nm4c/radio-remote/pihat/docs/schematic/radpi-control-hat.html

Title

# RadPi Control HAT

Raspberry Pi HAT: opto-isolated PTT, channel UP/DOWN and busy, an I2S codec with transformer-isolated radio audio, and a 13.8 V supply that powers the Pi.

RevA · draft

Date2026-11-02

Sheets7 + netlist

Board65 × 56.5 mm

GPIO17 Pi side (GND) R_PTT radio side (RGND) 5V0 power rail

Sheet 1/7

## Block diagram

Everything left of the dashed barrier is on Pi ground (GND). Everything right of it is on radio ground (RGND). Only optocouplers and transformers cross it.

Sheet 2/7

## Pi header J1

Only these pins are used. Every pin not listed is left unconnected. Pin numbers are physical header positions.

Pin | Pi function | Net | Goes to
1 | 3V3 | 3V3_PI | U2 IOVDD, Y1, U6, pull-ups
2 | 5V | 5V0 | power in (from U3)
3 | GPIO2 SDA1 | I2C_SDA | U2 SDA
4 | 5V | 5V0 | power in (from U3)
5 | GPIO3 SCL1 | I2C_SCL | U2 SCL
6 | GND | GND
9 | GND | GND
11 | GPIO17 | GPIO17 | R1 → U1 ch 1 (PTT), R8 → LED2
12 | GPIO18 PCM_CLK | I2S_BCLK | U2 BCLK
13 | GPIO27 | GPIO27 | R2 → U1 ch 2 (UP)
14 | GND | GND
15 | GPIO22 | GPIO22 | R3 → U1 ch 3 (DOWN)
16 | GPIO23 | GPIO23 | U1 pin 10 (BUSY in)
17 | 3V3 | 3V3_PI
20 | GND | GND
25 | GND | GND
27 | GPIO0 ID_SD | ID_SD | U6 SDA, R22
28 | GPIO1 ID_SC | ID_SC | U6 SCL, R23
30 | GND | GND
34 | GND | GND
35 | GPIO19 PCM_FS | I2S_LRCLK | U2 WCLK
37 | GPIO26 | CODEC_RST | U2 RESET, R21
38 | GPIO20 PCM_DIN | I2S_DOUT | ← U2 DOUT
39 | GND | GND
40 | GPIO21 PCM_DOUT | I2S_DIN | U2 DIN

Sheet 3/7

## Power

The 5V0 rail powers the Pi through header pins 2 and 4. 3V3A is a quiet analog rail for the codec; the Pi's own 3V3 is used only for logic.

Sheet 4/7

## Control

Channels 1–3 are driven from the Pi. Channel 4 is reversed: its LED sits on the radio side, so BUSY arrives isolated on GPIO23.

Sheet 5/7

## Radio connectors

All radio wiring goes through two vertical 3.5 mm pluggable headers, plugged in from above through the HAT opening. Make up one lead per radio from its accessory connector.

Sheet 6/7

## Codec

All 33 pins are shown so the KiCad symbol can be checked pin for pin. Crossed pins are no-connect.

Sheet 7/7

## Audio + ID EEPROM

Both transformers sit across the barrier. TX audio leaves the codec differentially; RX audio arrives differentially, so neither speaker wire is ever grounded.

Reference

## Netlist

Ref.pin for every connection. Use these names as KiCad net labels: same name, same net.

Net | Connects
13V8_IN | J2.1, F1.1
VIN_F | F1.2, D1 A
VIN | D1 K, D3 K, C16–C18, C19 +, U3.2 VIN, U3.3 EN
SW | U3.8, C20.2, L1.1
BOOT | U3.7, C20.1
VCC | U3.6, C28.1
FB | U3.5, R25.2, R26.1
5V0 | L1.2, C21–C23, R25.1, J1.2, J1.4, U4.3 IN, C24, R7
3V3A | U4.2 OUT, C25, U5.1 IN, U5.3 EN, C26, U2.25, U2.18, U2.24, C8, C9, C10, C13
1V8 | U5.5 OUT, C27, U2.32 DVDD, C12
3V3_PI | J1.1, J1.17, U2.7 IOVDD, C11, Y1.4, Y1.1, C14, U6.8, C15, R22, R23, R24
GND | J1 GND pins, J2.2, C16–C19, C21–C28, D3 A, R26, U3.1/9, U4.1, U5.2, U1.2/4/6/9, U2.6/17/21/26/33, Y1.2, U6.1–4, R21, LED1 K, LED2 K, JP1.2, JP2.2
GPIO17 | J1.11, R1.1, R8.1
GPIO27 | J1.13, R2.1
GPIO22 | J1.15, R3.1
GPIO23 | J1.16, U1.10 (C4)
I2C_SDA | J1.3, U2.9
I2C_SCL | J1.5, U2.8
I2S_BCLK | J1.12, U2.2
I2S_LRCLK | J1.35, U2.3
I2S_DIN | J1.40, U2.4 (codec DIN)
I2S_DOUT | J1.38, U2.5 (codec DOUT)
OSC_12M | Y1.3, R16 → U2.1 MCLK
CODEC_RST | J1.37, U2.31, R21.1
ID_SD | J1.27, U6.5, R22.2
ID_SC | J1.28, U6.6, R23.2
EE_WP | U6.7, R24.2, TP1, JP2.1
HP_P / HP_N | U2.19 / U2.20 → R14 / R15 → T1.1 / T1.3
T1 secondary | T1.6 → C1 → FB4 → R_MIC; T1.4 → RGND
RX_P / RX_N | C2 / C3 → U2.10 / U2.11
RGND | U1.11/13/15, C4, C7, T1.4, J3.2, J4.1, JP1.1
R_PTT | FB1.2, C4, J4.2
R_UP | U1.14 → JP3 ∥ R5 (not fitted), J4.3
R_DN | U1.12 → JP4 ∥ R6 (not fitted), J4.4
R_MIC | FB4.2, C7, J3.1
R_SPP / R_SPN | J3.3 / J3.4 → T2.6 / T2.4
BUSY+ | J4.5, R4.1
BUSY− | J4.6, U1.8 (K4), D4 A

Reference

## Parts

Designators match the sheets. LCSC numbers were checked against JLCPCB stock on 2 Nov 2026; put them in each symbol’s LCSC field.

Ref | Part | LCSC | JLC type
U1 | TCMT4100 quad opto, SOP-16 | C2938669 | Ext
U2 | TLV320AIC3104IRHBR codec, QFN-32 | C181753 | Ext
U3 | LMR33640ADDAR buck, HSOIC-8-EP | C2836966 | Ext
U4 | TLV76133DCYR 3.3 V LDO, SOT-223 | C7527500 | Ext
U5 | TPS7A2018PDBVR 1.8 V LDO, SOT-23-5 | C963430 | Ext
U6 | AT24C32D-SSHM-T EEPROM, SOIC-8 | C60583 | Ext
Y1 | HSO321S 12 MHz 3.3 V oscillator, 3225 | C160457 | Ext
T1, T2 | SM-LP-5001E 600:600 Ω transformer | C840532 | Ext
L1 | FXL0630-6R8-M 6.8 µH 5 A | C167221 | Ext
D1 | SS56 Schottky 60 V 5 A, SMA | C65009 | Ext
D3 | SMBJ22A TVS (Littelfuse), SMB | C224015 | Ext
D4 | 1N4148WS, SOD-323 | C2128 | Basic
F1 | 1812L150/33GR PTC 1.5 A 33 V | C18198333 | Ext
LED1, LED2 | KT-0603R red LED, 0603 | C2286 | Basic
FB1, FB4 | GZ1608D601TF ferrite 600 Ω, 0603 | C1002 | Basic
R1–R3 | 470 Ω 0603 | C23179 | Basic
R4 | 2.2 kΩ 0603 | C4190 | Basic
R5, R6 | Not fitted: 0603 footprints for ladder values (JP3/JP4 bridge them) | — | DNP
R7, R8, R24 | 1 kΩ 0603 | C21190 | Basic
R11, R12, R13, R21 | 10 kΩ 0603 | C25804 | Basic
R14–R16 | 33 Ω 0603 | C23140 | Basic
R22, R23 | 3.9 kΩ 0603 | C23018 | Basic
R25 | 82 kΩ 0603 1 % | C23254 | Basic
R26 | 20 kΩ 0603 1 % | C4184 | Basic
C1 | 1 µF 50 V X7R 0805 | C28323 | Basic
C2, C3, C24, C26–C28 | 1 µF 50 V X5R 0603 | C15849 | Basic
C4, C7 | 100 pF C0G 0603 | C14858 | Basic
C8–C12, C14, C15, C20 | 100 nF 50 V X7R 0603 | C14663 | Basic
C13, C25 | 10 µF 25 V X5R 0805 | C15850 | Basic
C16–C18 | 2.2 µF 50 V X7R 1206 | C50254 | Basic
C19 | 100 µF 50 V electrolytic 8×10.2 | C72480 | Ext
C21–C23 | 22 µF 25 V X5R 1206 | C12891 | Basic
J1 | 2×20 female header 2.54 mm | C2977589 | DNP · hand-solder
J2 | XY2500V-F-3.5-2P pluggable header, 3.5 mm, vertical, closed | C880554 | DNP · hand-solder
J3 | XY2500V-F-3.5-4P pluggable header, 3.5 mm, vertical, closed | C880556 | DNP · hand-solder
J4 | XY2500V-F-3.5-6P pluggable header, 3.5 mm, vertical, closed | C880558 | DNP · hand-solder
JP1–JP4, TP1 | PCB features only (solder jumpers; JP3/JP4 are closed by default; test pad) | — | —

Reference

## Before layout

1. Y1 pinout. The HSO321S datasheet is encrypted, so pin numbers follow the usual 3225 layout. Confirm before layout; tying pin 1 high is safe either way.
2. U3 stock. LMR33640ADDAR (C2836966) is an Extended part. LCSC showed about 2,400 in stock, but one JLCPCB snapshot showed only 6 available to order. Check the live JLC page before ordering; pre-order or consign if it is short.
3. Codec clocking. Y1 drives MCLK at 12 MHz. simple-audio-card always clocks the codec from MCLK, so a small custom overlay (codec at 0x18, reset on GPIO26, 12 MHz system clock) runs it correctly. The stock dacberry400 overlay clocks the PLL from BCLK while claiming 12 MHz: don't use it on this board.
4. IOVDD. Runs at 3.3 V (3V3_PI) to match Pi logic. The dacberry400 overlay describes IOVDD as 1.8 V; that only names a regulator for the driver and doesn't change the hardware.
5. Connector footprints. J2–J4 use footprints made from LCSC's data for the exact XY2500V-F parts (1.4 mm drills, 2.2 mm pads). Plugs go in from above, so leave room above them in the case opening.
6. Back-feeding. Don't power the Pi from USB-C with the HAT fitted and 13.8 V off: the Pi's 5 V would sit on the LMR33640's output with no input, which its datasheet says not to allow.
7. Isolation clearance. Keep RGND copper and every radio-side net at least 2 mm from GND-side copper, including under U1 and T1/T2.

Net-label style: a label with the same name on any sheet is the same net, as in KiCad. Pin numbers come from each part's datasheet; check them against the KiCad symbol you use.
