nm4c/radio-remote/assets/control-head/output/control-head-base@2x.png

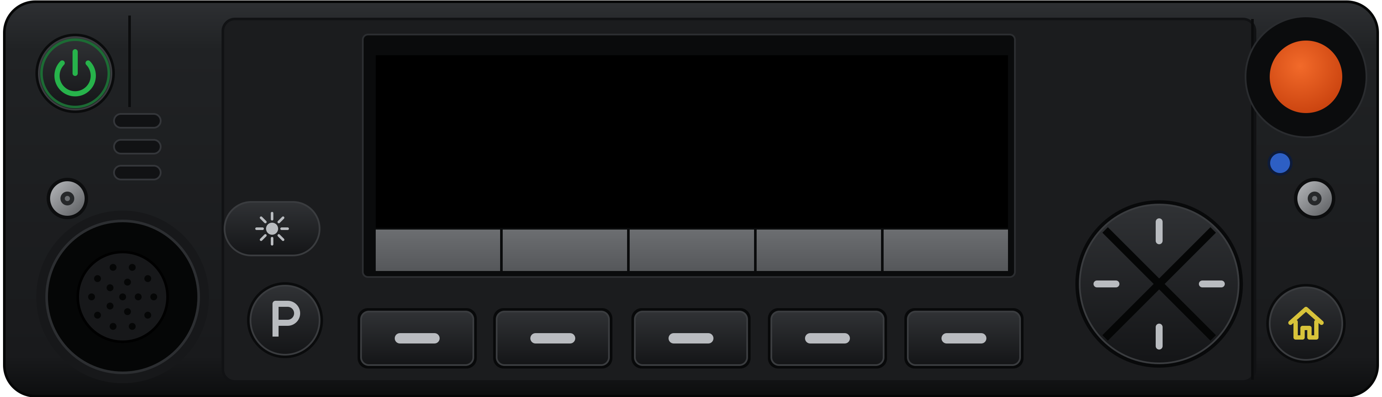
assets/control-head/output/control-head-base@2x.png
