nm4c/radio-remote/assets/control-head/output/control-head-cutout@2x.png

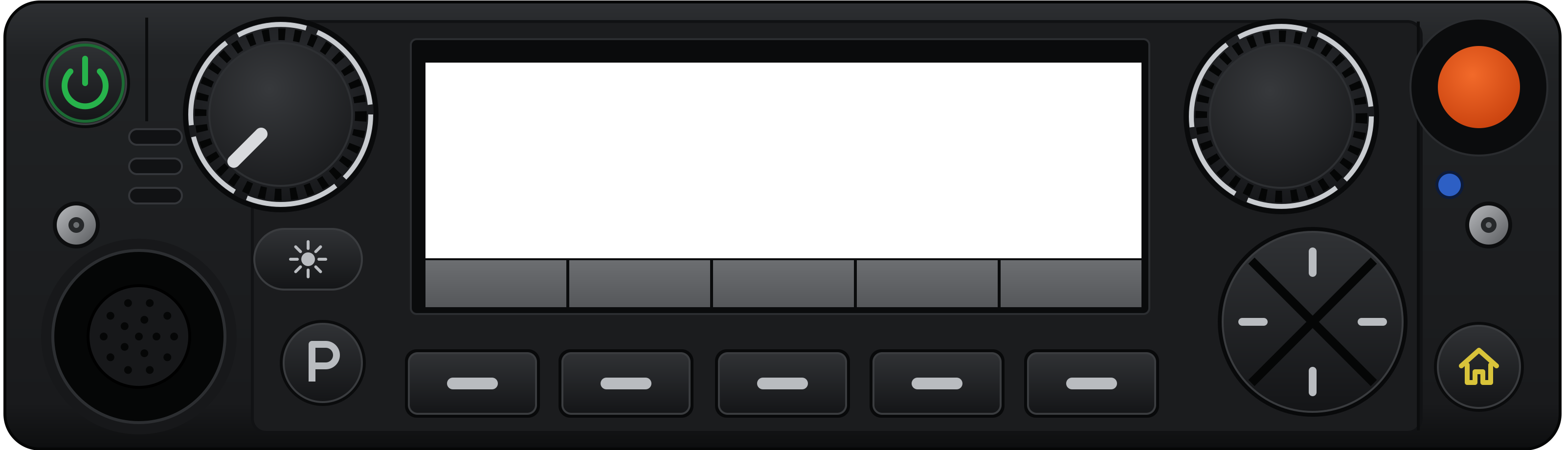
assets/control-head/output/control-head-cutout@2x.png
