nm4c/radio-remote/assets/control-head/output/handheld-sample@2x.png

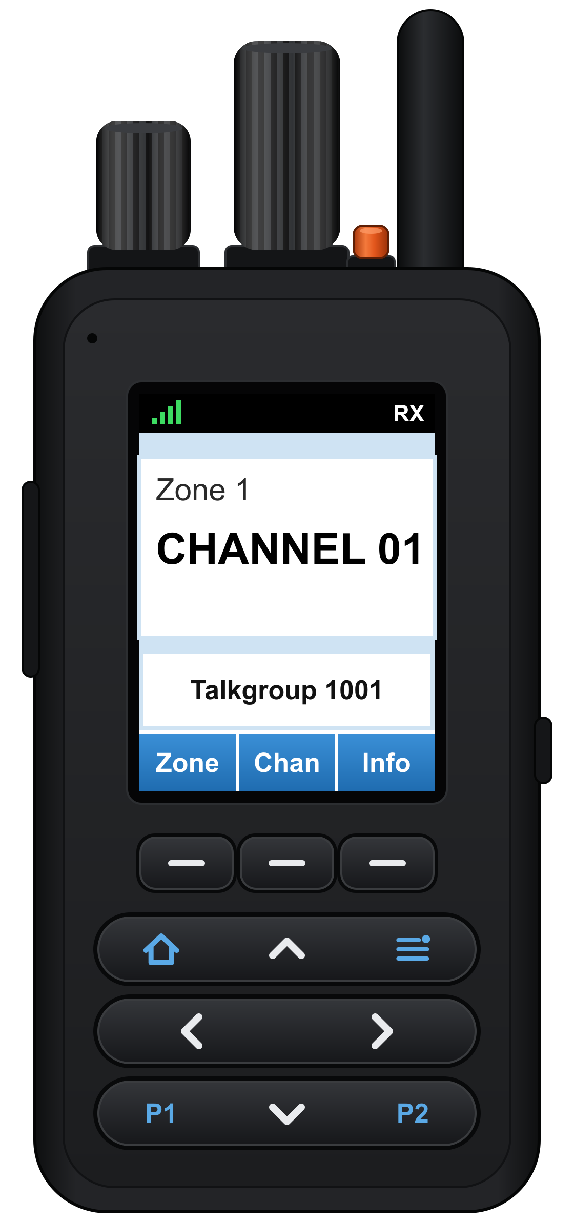
assets/control-head/output/handheld-sample@2x.png
