nm4c/radio-remote/assets/control-head/output/handheld@2x.png

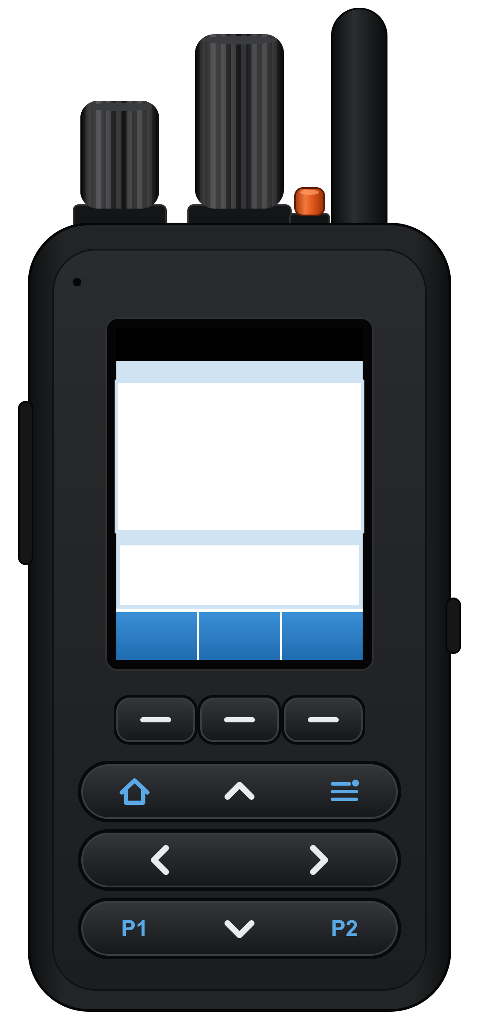
assets/control-head/output/handheld@2x.png
