nm4c/radio-remote/assets/control-head/output/knob-channel@2x.png

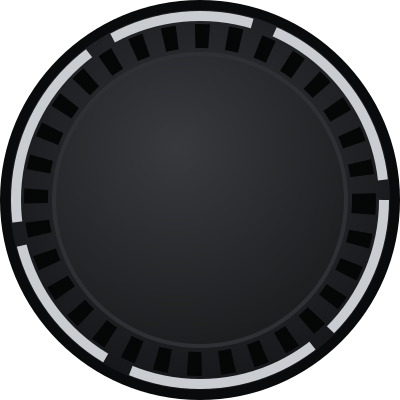
assets/control-head/output/knob-channel@2x.png
