nm4c/radio-remote/pihat/docs/BOM.md

# RadPi Control HAT: BoM notes (Rev A)

The full parts list, with designators, is in the schematic page
([`schematic/radpi-control-hat.html`](schematic/radpi-control-hat.html), "Parts" section) and in
[`jlc-bom.csv`](jlc-bom.csv), ready to upload to JLCPCB. Both come from the same list in
`schematic/gen.py`. Change the list there, then run `python3 gen.py` to update both.

LCSC numbers, JLC part type and stock were checked against JLCPCB on **2 Nov 2026**. Stock moves,
so re-check before ordering.

## Cost summary

| | Unique parts |
|---|---|
| **Basic** (no loading fee) | 18 |
| **Extended** (≈ US$3 each, per order) | 13 |

J1 (Pi header) and J2–J4 (pluggable headers) are **Do Not Populate**: through-hole, soldered by
hand. That leaves JLC only SMD parts, so the board qualifies for the cheaper "Economic" assembly,
and about US$39 in loading fees per order, not per board. To cut it further:
1. **Leave the power section off** (U3, L1, D1, D3, F1, C19, C28) if the Pi has its own supply. That's
   6 fewer Extended parts. The codec rails (U4, U5) are still needed and run from the Pi's 5 V.

## Design choices

- **Basic parts wherever possible:** all resistors, nearly all capacitors, ferrites, LEDs and D4.
- **Reused values:** 33 Ω for all series resistors, 10 kΩ for the pads and pull-downs, 100 pF and a
  ferrite on the two RF-sensitive radio lines (PTT and MIC).
- **Synchronous buck:** the LMR33640 has its own low-side switch and internal compensation, so
  there is no catch diode, compensation network or frequency resistor.
- **TI regulators:** TLV76133 for 3.3 V. The TLV76118 (1.8 V) has too little stock, so the 1.8 V
  rail uses a TPS7A2018 instead: TI, very low noise, 11k in stock.
  Avoid the "TP"-prefixed look-alikes JLC lists (3PEAK clones, not TI).
- **TCMT4100 quad opto:** one package for all four channels. At its 50 % minimum gain, 470 Ω from
  3.3 V (≈ 4 mA) still sinks ≥ 2 mA on the radio side.
- **No trimmers or TX pad:** the codec sets the TX level in software, from line level down to mic
  level. The RX pad (R11/R12/R13, −9.5 dB) suits line-level RX audio; from a speaker output, fit
  R13 = 1 kΩ (−26 dB).
- **Feedback from Basic values only:** 82 kΩ over 20 kΩ with the LMR33640's 1.0 V reference gives 5.10 V.
- **Pluggable radio connectors:** Xinlaiya XY2500V-F, 3.5 mm pitch, vertical with closed ends,
  8 A / 300 V, so the plugs go in from above through the HAT opening. J2 13.8 V in (2 way), J3
  audio (4 way: TX, TX return, RX+, RX−), J4 radio (6 way: ground, PTT, UP, DOWN, BUSY+, BUSY−).
  Each radio gets its own lead with mating 3.5 mm plugs (XY2500F / Phoenix MC 1,5/x-ST-3,5 style).

## Still to do before ordering

See the "Before layout" checklist at the end of the schematic page. In short:
- **Y1 pinout:** confirm it (the datasheet is encrypted).
- **U3 stock:** LMR33640ADDAR (C2836966) is Extended. One JLCPCB snapshot showed very few
  available to order, so check the live page; pre-order or consign if it is short.
- **Codec clock:** confirm the clock setup at bring-up.
- **Connector footprints:** J2–J4 use footprints made from LCSC's data for the exact XY2500V-F
  parts (1.4 mm drills). Leave room above them for the plugs and wires.
- **Isolation clearance:** keep radio-side copper ≥ 2 mm from Pi-side copper.
