nm4c/radio-remote/pihat/docs/jlc-bom.csv

Comment | Designator | Footprint | LCSC Part #
TCMT4100 quad opto | U1 | SOIC-16_4.4x10.3mm_P1.27mm | C2938669
TLV320AIC3104IRHBR codec | U2 | QFN-32-1EP_5x5mm_P0.5mm | C181753
LMR33640ADDAR buck | U3 | HSOP-8-1EP_3.9x4.9mm_P1.27mm | C2836966
TLV76133DCYR 3.3 V LDO | U4 | SOT-223-3_TabPin2 | C7527500
TPS7A2018PDBVR 1.8 V LDO | U5 | SOT-23-5 | C963430
AT24C32D-SSHM-T EEPROM | U6 | SOIC-8_3.9x4.9mm_P1.27mm | C60583
HSO321S 12 MHz 3.3 V oscillator | Y1 | Oscillator_SMD_3225-4Pin | C160457
SM-LP-5001E 600:600 Ω transformer | T1,T2 | Bourns_SM-LP-5001 | C840532
FXL0630-6R8-M 6.8 µH 5 A | L1 | L_Changjiang_FXL0630 | C167221
SS56 Schottky 60 V 5 A | D1 | D_SMA | C65009
SMBJ22A TVS (Littelfuse) | D3 | D_SMB | C224015
1N4148WS | D4 | D_SOD-323 | C2128
1812L150/33GR PTC 1.5 A 33 V | F1 | Fuse_1812 | C18198333
KT-0603R red LED | LED1,LED2 | LED_0603 | C2286
GZ1608D601TF ferrite 600 Ω | FB1,FB4 | L_0603 | C1002
470 Ω 0603 | R1,R2,R3 | R_0603 | C23179
2.2 kΩ 0603 | R4 | R_0603 | C4190
1 kΩ 0603 | R7,R8,R24 | R_0603 | C21190
10 kΩ 0603 | R11,R12,R13,R21 | R_0603 | C25804
33 Ω 0603 | R14,R15,R16 | R_0603 | C23140
3.9 kΩ 0603 | R22,R23 | R_0603 | C23018
82 kΩ 0603 1 % | R25 | R_0603 | C23254
20 kΩ 0603 1 % | R26 | R_0603 | C4184
1 µF 50 V X7R 0805 | C1 | C_0805 | C28323
1 µF 50 V X5R 0603 | C2,C3,C24,C26,C27,C28 | C_0603 | C15849
100 pF C0G 0603 | C4,C7 | C_0603 | C14858
100 nF 50 V X7R 0603 | C8,C9,C10,C11,C12,C14,C15,C20 | C_0603 | C14663
10 µF 25 V X5R 0805 | C13,C25 | C_0805 | C15850
2.2 µF 50 V X7R 1206 | C16,C17,C18 | C_1206 | C50254
100 µF 50 V electrolytic 8×10.2 | C19 | CP_Elec_8x10.2 | C72480
22 µF 25 V X5R 1206 | C21,C22,C23 | C_1206 | C12891
