nm4c/radio-remote/kicad-shared/3dmodels/Kinghelm_KH-SMAK-SMT.step

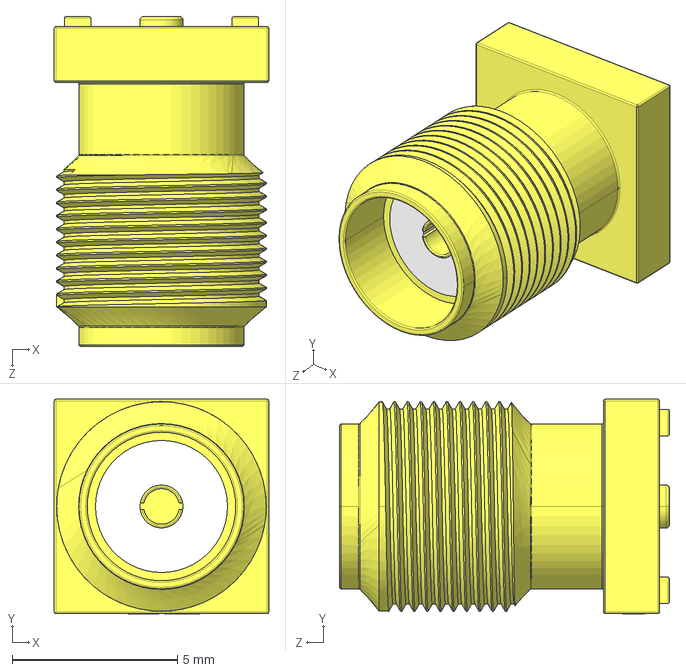
[picture p13: CAD file, 2026-11-11]
kicad-shared/3dmodels/Kinghelm_KH-SMAK-SMT.step
6.50 x 6.50 x 10.0 mm
