nm4c/radio-remote/kicad-shared/3dmodels/TI_WSON-10_DSC.step

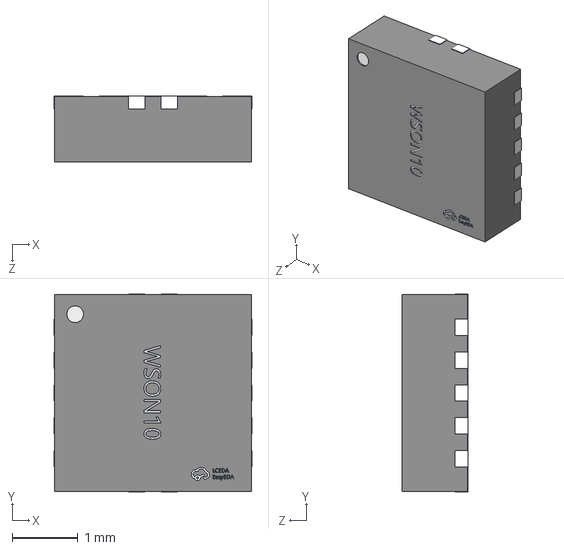
[picture p14: CAD file, 2026-11-11]
kicad-shared/3dmodels/TI_WSON-10_DSC.step
3.02 x 3.02 x 1.01 mm
