nm4c/radio-remote/kicad-shared/3dmodels/Xinlaiya_XY2500V-F-3.5-4P.step

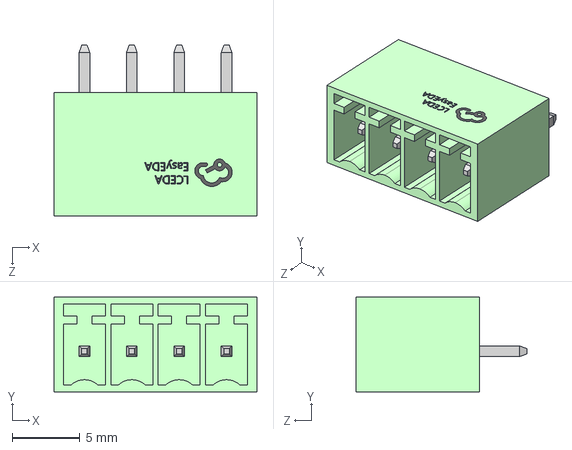
[picture p15: CAD file, 2026-11-09]
kicad-shared/3dmodels/Xinlaiya_XY2500V-F-3.5-4P.step
15.0 x 7.00 x 12.6 mm
