nm4c/radio-remote/kicad-shared/3dmodels/Xinlaiya_XY2500V-F-3.5-2P.step

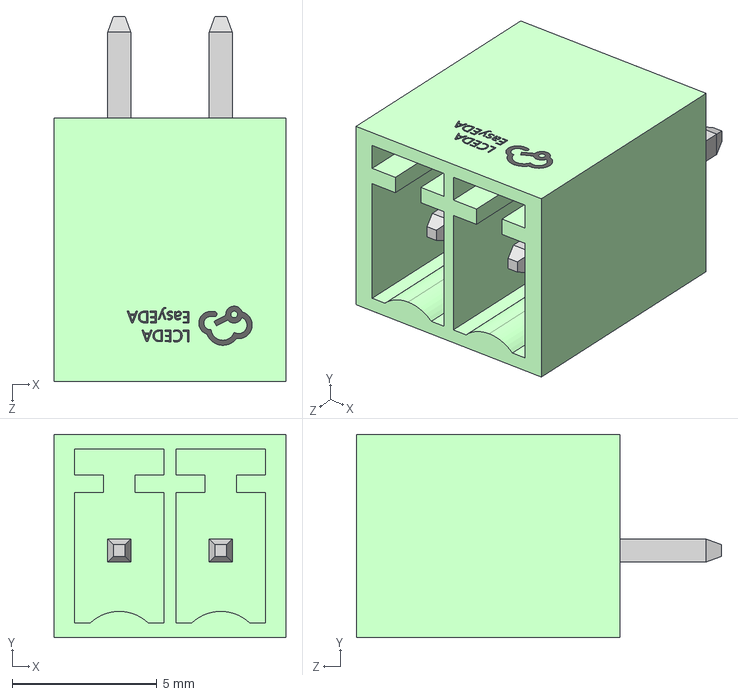
[picture p17: CAD file, 2026-11-09]
kicad-shared/3dmodels/Xinlaiya_XY2500V-F-3.5-2P.step
8.00 x 7.00 x 12.6 mm
