nm4c/radio-remote/kicad-shared/3dmodels/PTC_1812_4.5x3.2x1.0mm.step

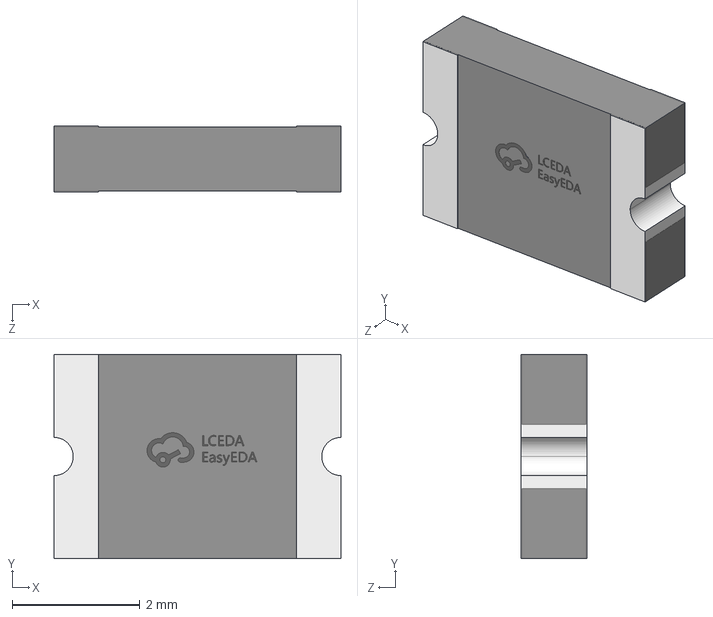
[picture p18: CAD file, 2026-11-09]
kicad-shared/3dmodels/PTC_1812_4.5x3.2x1.0mm.step
4.50 x 3.20 x 1.04 mm
