nm4c/radio-remote/kicad-shared/3dmodels/Oscillator_3225_HSO321S.step

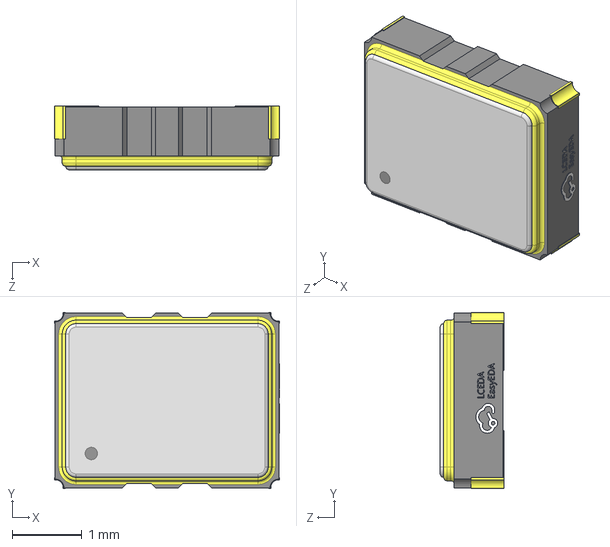
[picture p19: CAD file, 2026-11-09]
kicad-shared/3dmodels/Oscillator_3225_HSO321S.step
3.22 x 2.52 x 0.91 mm
