nm4c/radio-remote/kicad-shared/3dmodels/Bourns_SM-LP-5001E.step

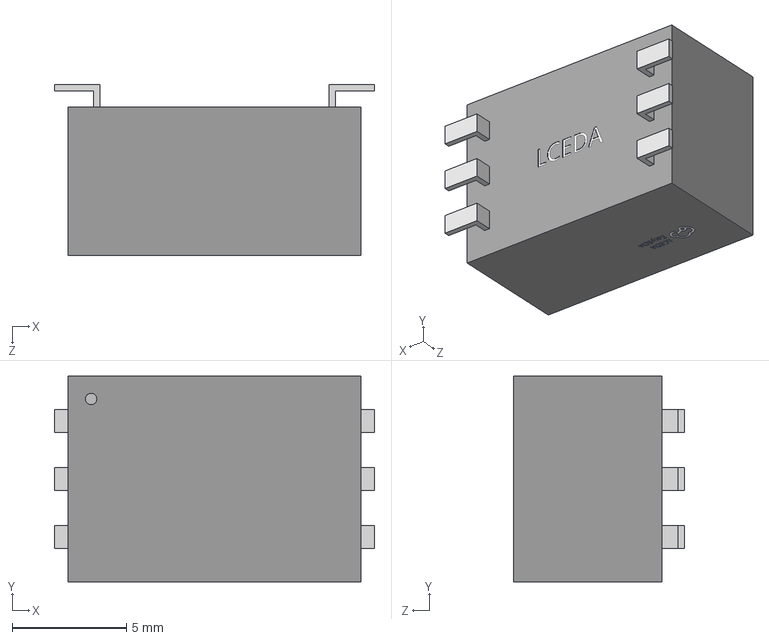
[picture p20: CAD file, 2026-11-09]
kicad-shared/3dmodels/Bourns_SM-LP-5001E.step
14.0 x 9.00 x 7.50 mm
