nm4c/radio-remote/kicad-shared/3dmodels/NiceRF_SA818S.step

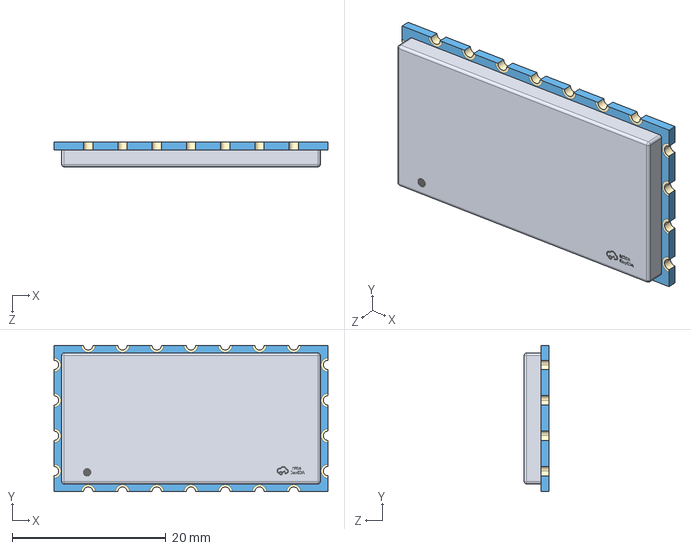
[picture p21: CAD file, 2026-11-09]
kicad-shared/3dmodels/NiceRF_SA818S.step
35.6 x 19.0 x 3.22 mm
