nm4c/radio-remote/sa818s-hat/sa818s-hat.kicad_pcb

## KiCad design sa818s-hat/sa818s-hat.kicad_pcb (2026-11-12)

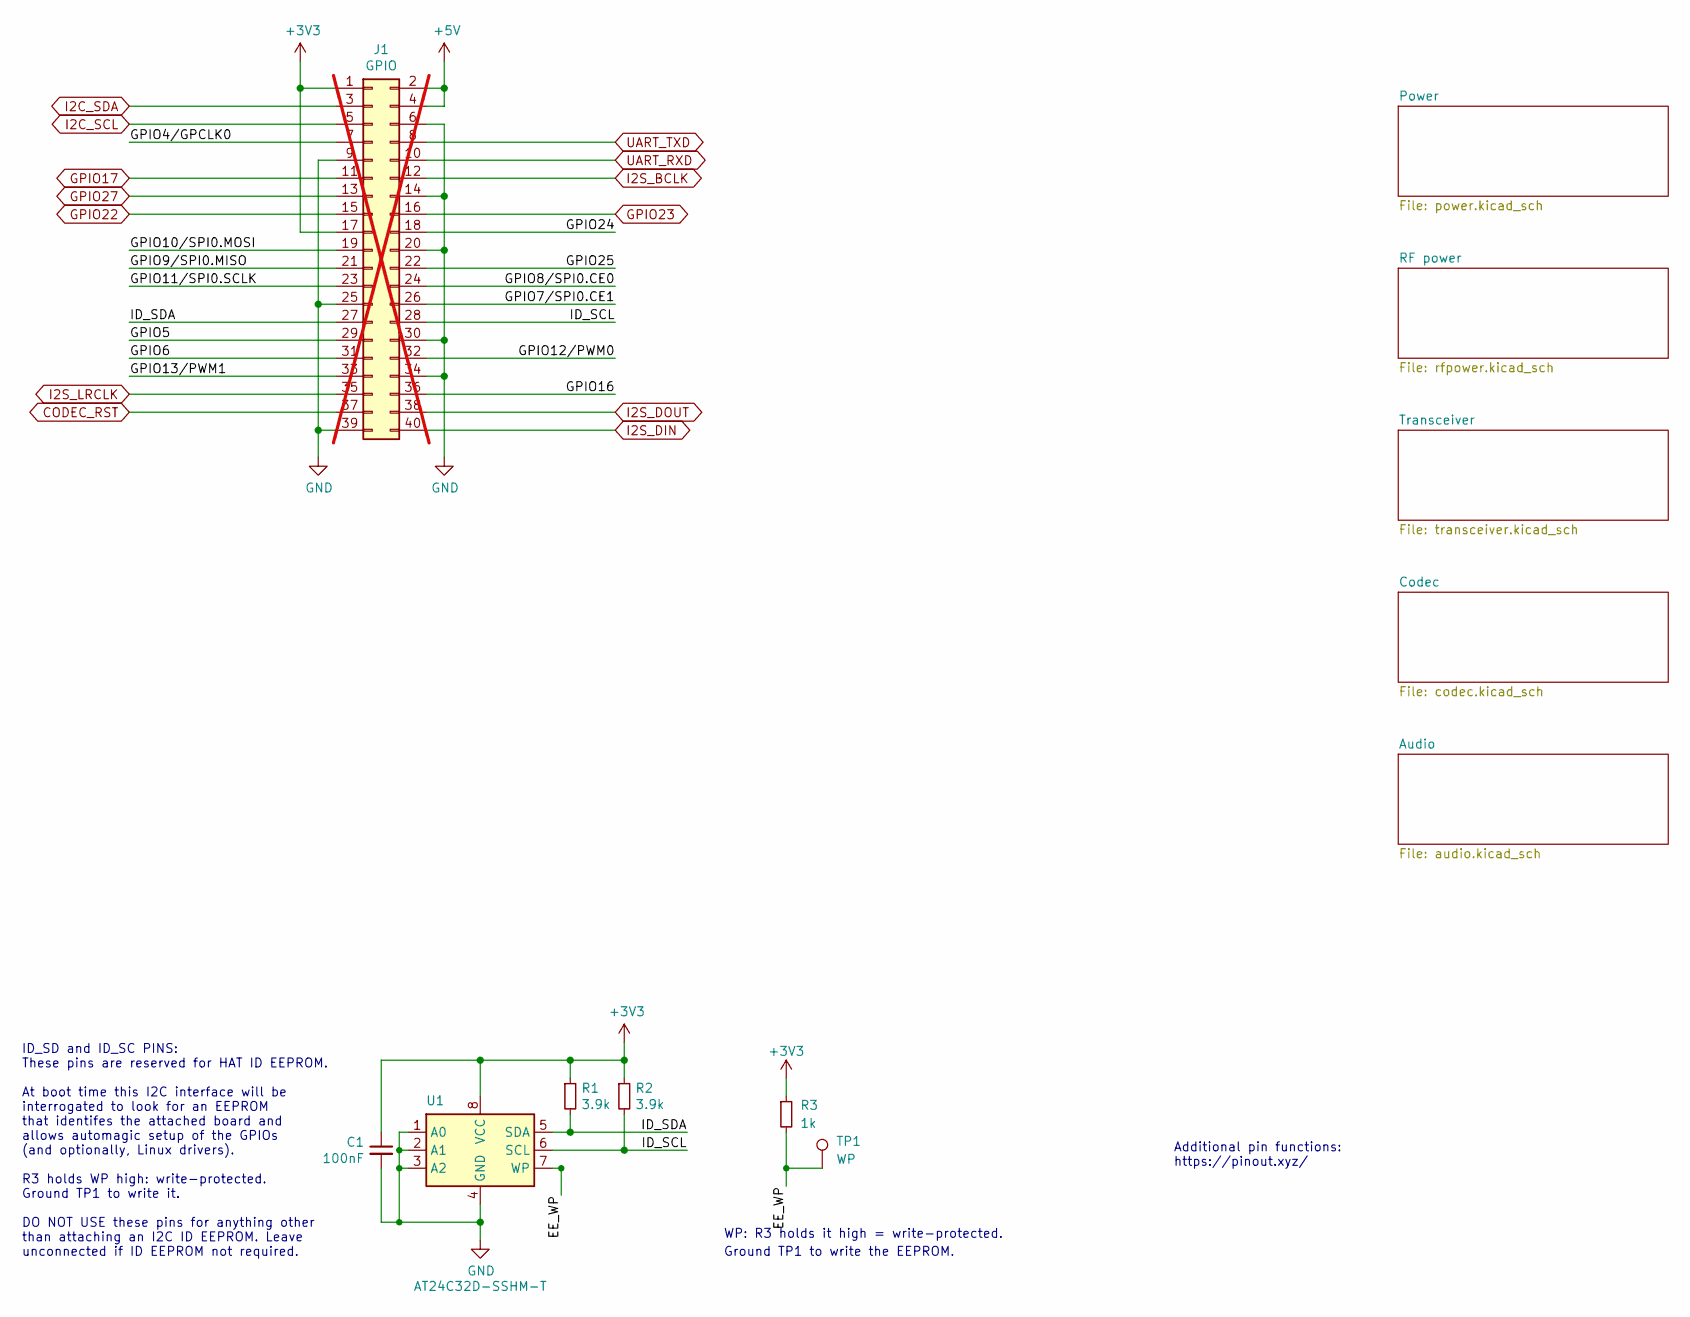
[picture p22: schematic sa818s-hat.kicad_sch]

Parts:
C1: 100nF; C_0603_1608Metric; LCSC C14663
J1: GPIO; PinSocket_2x20_P2.54mm_Vertical; LCSC C2977589; not fitted
R1, R2: 3.9k; R_0603_1608Metric; LCSC C23018
R3: 1k; R_0603_1608Metric; LCSC C21190
TP1: WP; TestPoint_Pad_D1.5mm
U1: AT24C32D-SSHM-T; SOIC-8_3.9x4.9mm_P1.27mm; LCSC C60583

Connections:
+3V3: C1.1, J1.1, J1.17, R1.1, R2.1, R3.1, U1.8 (VCC); also elsewhere on the board
+5V: J1.2, J1.4; also elsewhere on the board
/EE_WP: R3.2, TP1.1 (1_1), U1.7 (WP)
/GPIO4/GPCLK0: J1.7
/GPIO5: J1.29
/GPIO6: J1.31
/GPIO7/SPI0.CE1: J1.26
/GPIO8/SPI0.CE0: J1.24
/GPIO9/SPI0.MISO: J1.21
/GPIO10/SPI0.MOSI: J1.19
/GPIO11/SPI0.SCLK: J1.23
/GPIO12/PWM0: J1.32
/GPIO13/PWM1: J1.33
/GPIO16: J1.36
/GPIO24: J1.18
/GPIO25: J1.22
/ID_SCL: J1.28, R2.2, U1.6 (SCL)
/ID_SDA: J1.27, R1.2, U1.5 (SDA)
CODEC_RST: J1.37; also elsewhere on the board
GND: C1.2, J1.6, J1.9, J1.14, J1.20, J1.25, J1.30, J1.34, J1.39, U1.1 (A0), U1.2 (A1), U1.3 (A2), U1.4 (GND); also elsewhere on the board
GPIO17: J1.11; also elsewhere on the board
GPIO22: J1.15; also elsewhere on the board
GPIO23: J1.16; also elsewhere on the board
GPIO27: J1.13; also elsewhere on the board
I2C_SCL: J1.5; also elsewhere on the board
I2C_SDA: J1.3; also elsewhere on the board
I2S_BCLK: J1.12; also elsewhere on the board
I2S_DIN: J1.40; also elsewhere on the board
I2S_DOUT: J1.38; also elsewhere on the board
I2S_LRCLK: J1.35; also elsewhere on the board
UART_RXD: J1.10; also elsewhere on the board
UART_TXD: J1.8; also elsewhere on the board

Notes on the sheet:
Additional pin functions: https://pinout.xyz/
ID_SD and ID_SC PINS: These pins are reserved for HAT ID EEPROM. At boot time this I2C interface will be interrogated to look for an EEPROM that identifes the attached board and allows automagic setup of the GPIOs (and optionally, Linux drivers). R3 holds WP high: write-protected. Ground TP1 to wri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
WP: R3 holds it high = write-protected.
Ground TP1 to write the EEPROM.

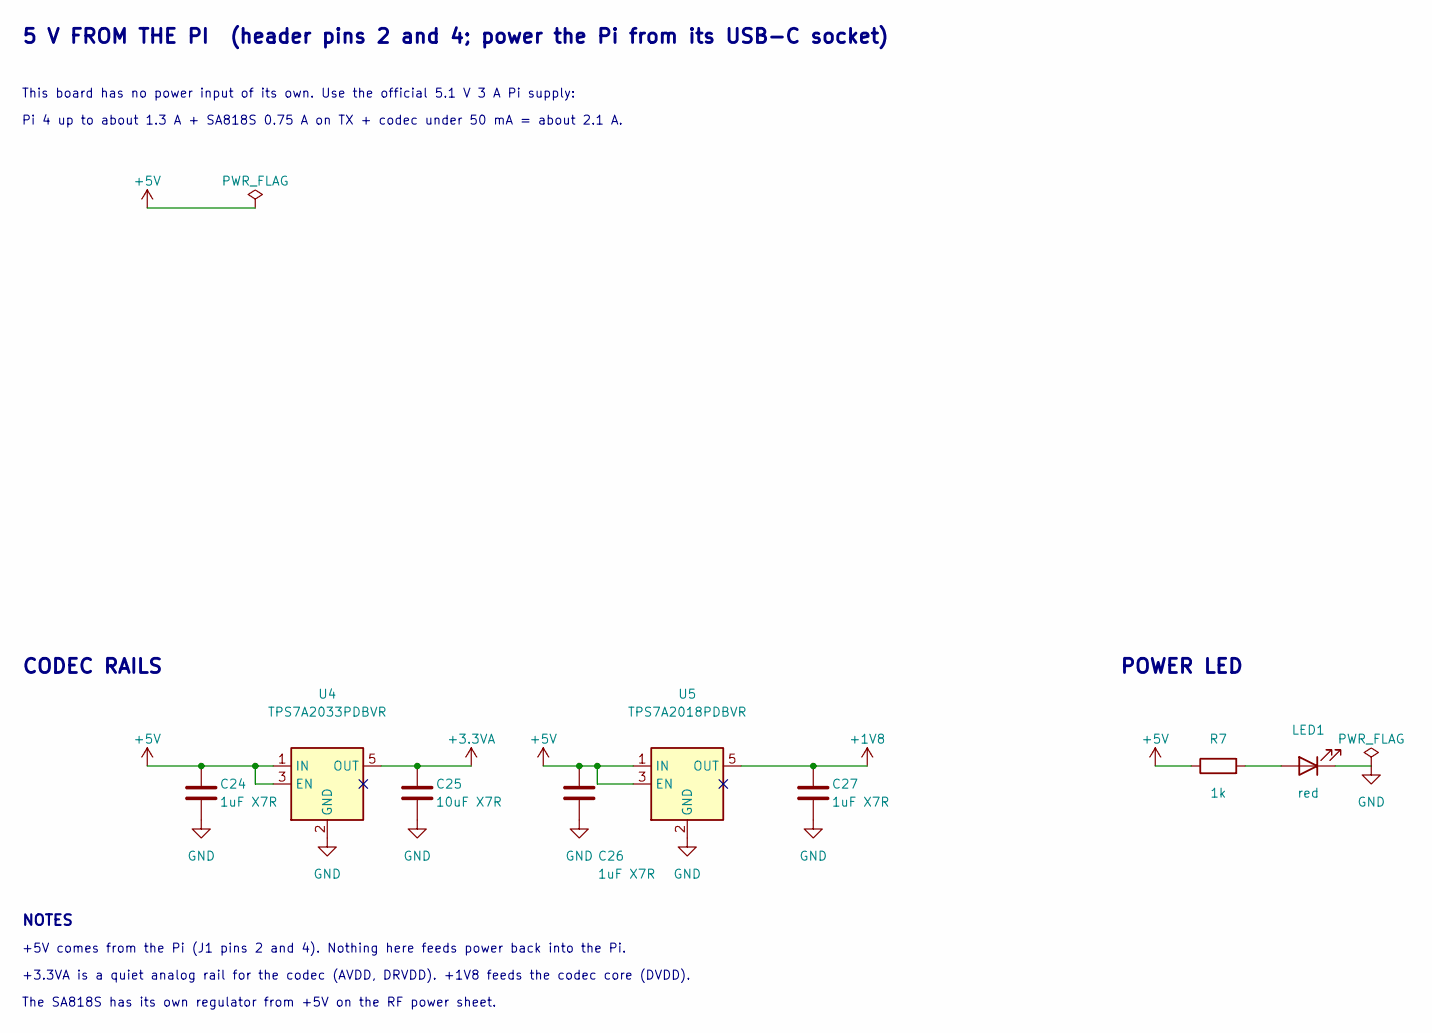
[picture p23: schematic power.kicad_sch]

Parts:
C24, C26, C27: 1uF X7R; C_0603_1608Metric; LCSC C29936
C25: 10uF X7R; C_0805_2012Metric; LCSC C95841
LED1: red; LED_0603_1608Metric; LCSC C2286
R7: 1k; R_0603_1608Metric; LCSC C21190
U4: TPS7A2033PDBVR; SOT-23-5; LCSC C2862740
U5: TPS7A2018PDBVR; SOT-23-5; LCSC C963430

Connections:
+1V8: C27.1, U5.5 (OUT); also elsewhere on the board
+3.3VA: C25.1, U4.5 (OUT); also elsewhere on the board
+5V: C24.1, C26.1, R7.1, U4.1 (IN), U4.3 (EN), U5.1 (IN), U5.3 (EN); also elsewhere on the board
GND: C24.2, C25.2, C26.2, C27.2, LED1.1 (K), U4.2 (GND), U5.2 (GND); also elsewhere on the board
unnamed: LED1.2 (A), R7.2

Notes on the sheet:
5 V FROM THE PI (header pins 2 and 4; power the Pi from its USB-C socket)
This board has no power input of its own. Use the official 5.1 V 3 A Pi supply:
Pi 4 up to about 1.3 A + SA818S 0.75 A on TX + codec under 50 mA = about 2.1 A.
CODEC RAILS
POWER LED
NOTES
+5V comes from the Pi (J1 pins 2 and 4). Nothing here feeds power back into the Pi.
+3.3VA is a quiet analog rail for the codec (AVDD, DRVDD). +1V8 feeds the codec core (DVDD).
The SA818S has its own regulator from +5V on the RF power sheet.

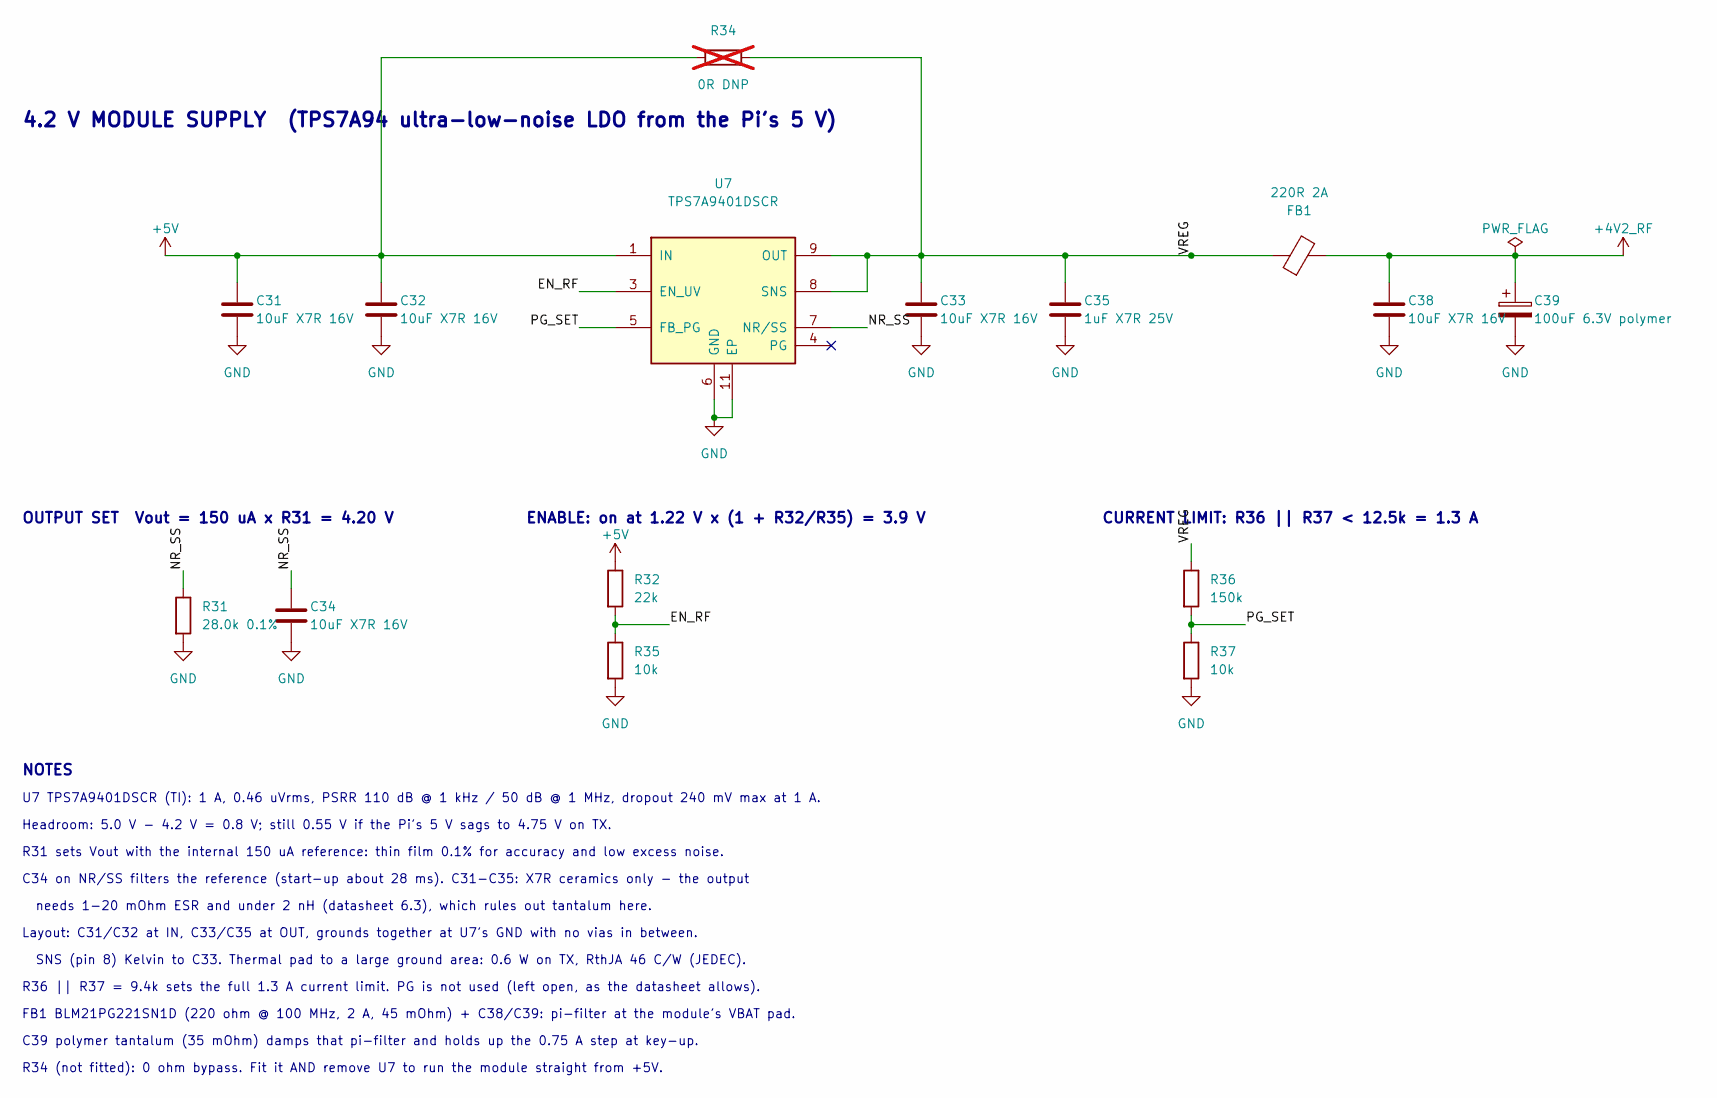
[picture p24: schematic rfpower.kicad_sch, RF power]

Parts:
C31, C32, C33, C34, C38: 10uF X7R 16V; C_0805_2012Metric; LCSC C95841
C35: 1uF X7R 25V; C_0603_1608Metric; LCSC C29936
C39: 100uF 6.3V polymer; CP_EIA-3528-21_Kemet-B; MPN Panasonic 6TPE100MAZB (POSCAP, 35 mOhm); LCSC C79109
FB1: 220R 2A; L_0805_2012Metric; LCSC C85840
R31: 28.0k 0.1%; R_0603_1608Metric; MPN FH TD03G2802BT (thin film, 0.1%, 25 ppm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; LCSC C667083
R32: 22k; R_0603_1608Metric; LCSC C31850
R34: 0R DNP; R_1206_3216Metric; not fitted
R35, R37: 10k; R_0603_1608Metric; LCSC C25804
R36: 150k; R_0603_1608Metric; LCSC C22807
U7: TPS7A9401DSCR; Texas_DSC0010J_ThermalVias; LCSC C5220127

Connections:
+4V2_RF: C38.1, C39.1, FB1.2; also elsewhere on the board
+5V: C31.1, C32.1, R32.1, R34.1, U7.1 (IN), U7.2 (IN); also elsewhere on the board
/RF power/EN_RF: R32.2, R35.1, U7.3 (EN_UV)
/RF power/NR_SS: C34.1, R31.1, U7.7 (NR/SS)
/RF power/PG_SET: R36.2, R37.1, U7.5 (FB_PG)
/RF power/VREG: C33.1, C35.1, FB1.1, R34.2, R36.1, U7.8 (SNS), U7.9 (OUT), U7.10 (OUT)
GND: C31.2, C32.2, C33.2, C34.2, C35.2, C38.2, C39.2, R31.2, R35.2, R37.2, U7.6 (GND), U7.11 (EP); also elsewhere on the board

Notes on the sheet:
4.2 V MODULE SUPPLY (TPS7A94 ultra-low-noise LDO from the Pi's 5 V)
OUTPUT SET Vout = 150 uA x R31 = 4.20 V
ENABLE: on at 1.22 V x (1 + R32/R35) = 3.9 V
CURRENT LIMIT: R36 || R37 < 12.5k = 1.3 A
NOTES
U7 TPS7A9401DSCR (TI): 1 A, 0.46 uVrms, PSRR 110 dB @ 1 kHz / 50 dB @ 1 MHz, dropout 240 mV max at 1 A.
Headroom: 5.0 V - 4.2 V = 0.8 V; still 0.55 V if the Pi's 5 V sags to 4.75 V on TX.
R31 sets Vout with the internal 150 uA reference: thin film 0.1% for accuracy and low excess noise.
C34 on NR/SS filters the reference (start-up about 28 ms). C31-C35: X7R ceramics only - the output
needs 1-20 mOhm ESR and under 2 nH (datasheet 6.3), which rules out tantalum here.
Layout: C31/C32 at IN, C33/C35 at OUT, grounds together at U7's GND with no vias in between.
SNS (pin 8) Kelvin to C33. Thermal pad to a large ground area: 0.6 W on TX, RthJA 46 C/W (JEDEC).
R36 || R37 = 9.4k sets the full 1.3 A current limit. PG is not used (left open, as the datasheet allows).
FB1 BLM21PG221SN1D (220 ohm @ 100 MHz, 2 A, 45 mOhm) + C38/C39: pi-filter at the module's VBAT pad.
C39 polymer tantalum (35 mOhm) damps that pi-filter and holds up the 0.75 A step at key-up.
R34 (not fitted): 0 ohm bypass. Fit it AND remove U7 to run the module straight from +5V.

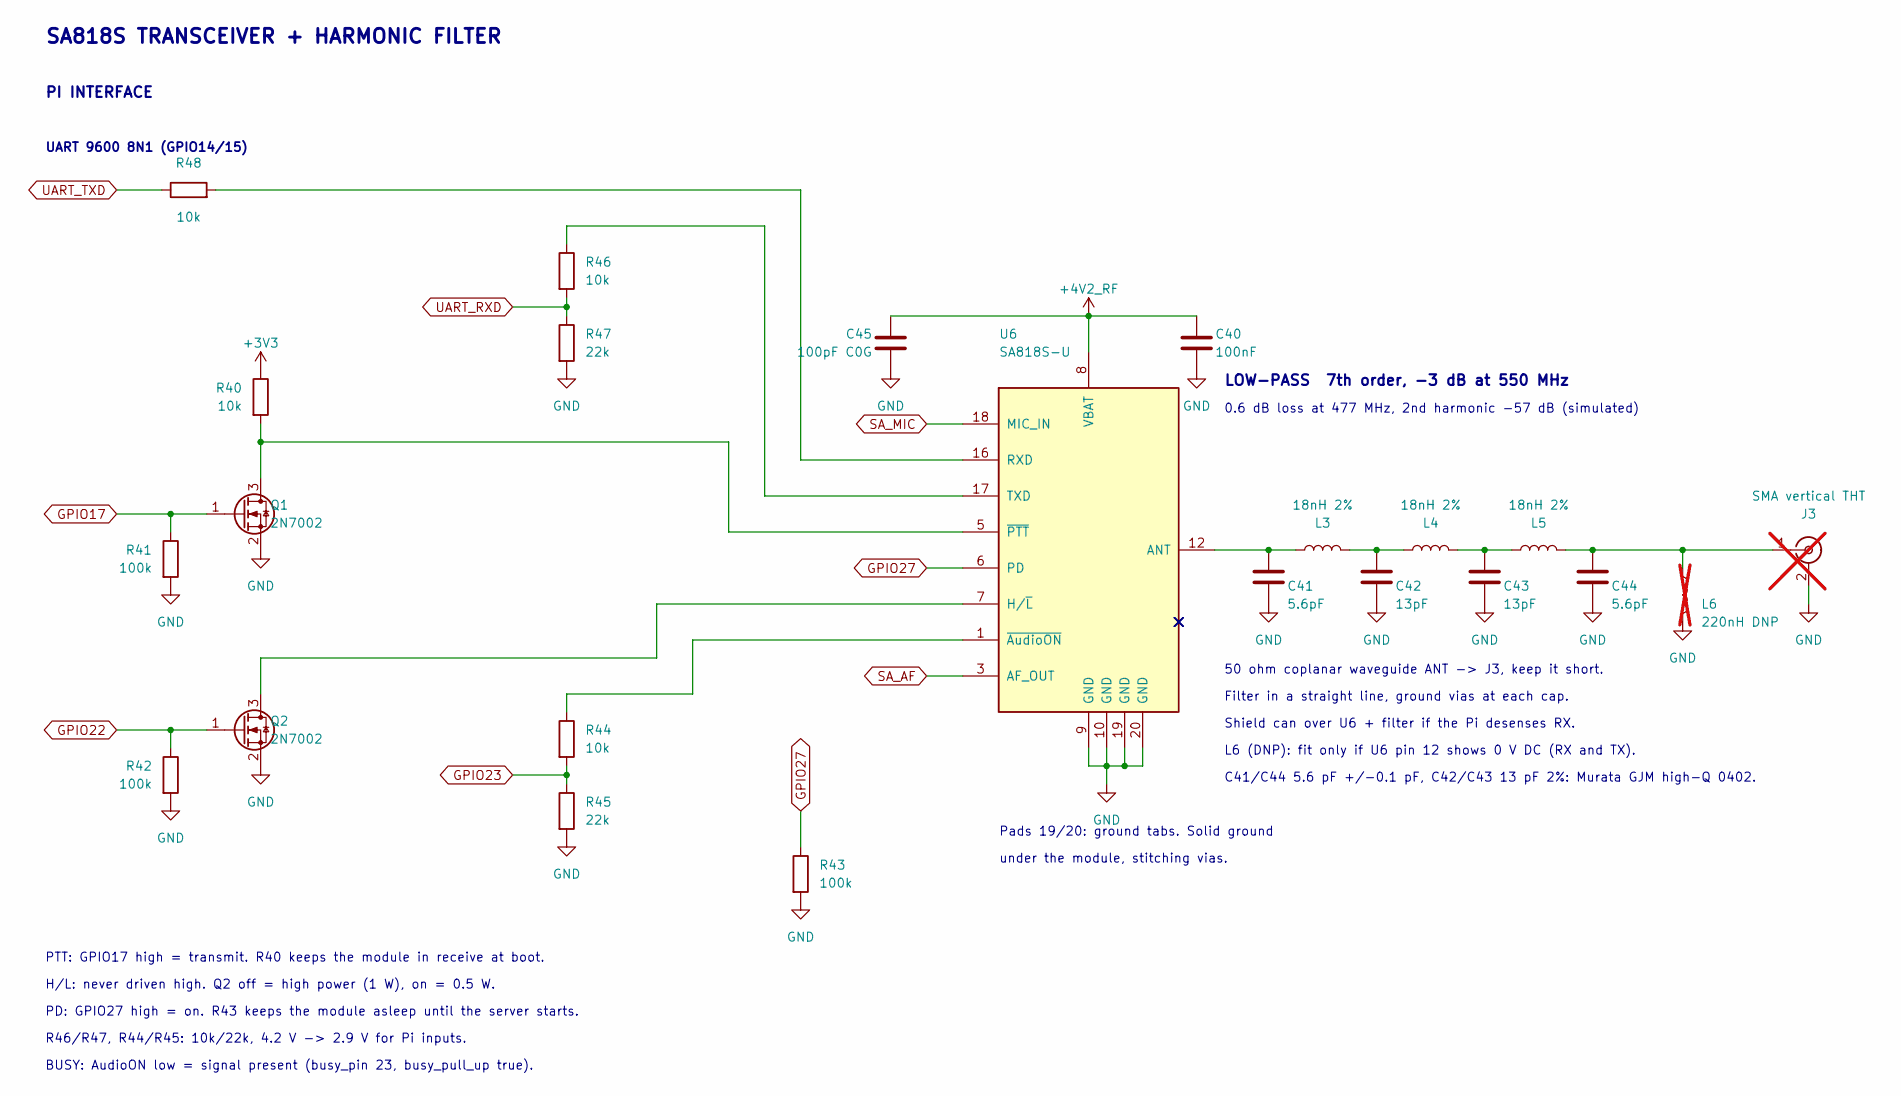
[picture p25: schematic transceiver.kicad_sch]

Parts:
C40: 100nF; C_0603_1608Metric; LCSC C14663
C41, C44: 5.6pF; C_0402_1005Metric; LCSC C161329
C42, C43: 13pF; C_0402_1005Metric; LCSC C2167421
C45: 100pF C0G; C_0603_1608Metric; LCSC C14858
J3: SMA vertical THT; SMA_Amphenol_132134-11_Vertical; MPN Amphenol RF 132134-11, or any vertical 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; not fitted
L3, L4, L5: 18nH 2%; L_0603_1608Metric; LCSC C1330613
L6: 220nH DNP; L_0603_1608Metric; MPN Coilcraft 0603CS-R22XGLU (220 nH 2%, SR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; not fitted
Q1, Q2: 2N7002; SOT-23; LCSC C8545
R40, R44, R46, R48: 10k; R_0603_1608Metric; LCSC C25804
R41, R42, R43: 100k; R_0603_1608Metric; LCSC C25803
R45, R47: 22k; R_0603_1608Metric; LCSC C31850
U6: SA818S-U; NiceRF_SA818S; LCSC C3001549

Connections:
+3V3: R40.1; also elsewhere on the board
+4V2_RF: C40.1, C45.1, U6.8 (VBAT); also elsewhere on the board
GND: C40.2, C41.2, C42.2, C43.2, C44.2, C45.2, J3.2 (Ext), L6.2, Q1.2 (S), Q2.2 (S), R41.2, R42.2, R43.2, R45.2, R47.2, U6.9 (GND), U6.10 (GND), U6.19 (GND), U6.20 (GND); also elsewhere on the board
GPIO17: Q1.1 (G), R41.1; also elsewhere on the board
GPIO22: Q2.1 (G), R42.1; also elsewhere on the board
GPIO23: R44.2, R45.1; also elsewhere on the board
GPIO27: R43.1, U6.6 (PD); also elsewhere on the board
unnamed: C42.1, L3.2, L4.1
unnamed: C43.1, L4.2, L5.1
unnamed: C44.1, J3.1 (In), L5.2, L6.1
unnamed: Q1.3 (D), R40.2, U6.5 (~PTT)
unnamed: Q2.3 (D), U6.7 (H/~L)
unnamed: C41.1, L3.1, U6.12 (ANT)
unnamed: R48.2, U6.16 (RXD)
unnamed: R46.1, U6.17 (TXD)
unnamed: R44.1, U6.1 (~AudioON)
SA_AF: U6.3 (AF_OUT); also elsewhere on the board
SA_MIC: U6.18 (MIC_IN); also elsewhere on the board
UART_RXD: R46.2, R47.1; also elsewhere on the board
UART_TXD: R48.1; also elsewhere on the board

Notes on the sheet:
SA818S TRANSCEIVER + HARMONIC FILTER
Pads 19/20: ground tabs. Solid ground
under the module, stitching vias.
LOW-PASS 7th order, -3 dB at 550 MHz
0.6 dB loss at 477 MHz, 2nd harmonic -57 dB (simulated)
50 ohm coplanar waveguide ANT -> J3, keep it short.
Filter in a straight line, ground vias at each cap.
Shield can over U6 + filter if the Pi desenses RX.
L6 (DNP): fit only if U6 pin 12 shows 0 V DC (RX and TX).
C41/C44 5.6 pF +/-0.1 pF, C42/C43 13 pF 2%: Murata GJM high-Q 0402.
PI INTERFACE
UART 9600 8N1 (GPIO14/15)
PTT: GPIO17 high = transmit. R40 keeps the module in receive at boot.
H/L: never driven high. Q2 off = high power (1 W), on = 0.5 W.
PD: GPIO27 high = on. R43 keeps the module asleep until the server starts.
R46/R47, R44/R45: 10k/22k, 4.2 V -> 2.9 V for Pi inputs.
BUSY: AudioON low = signal present (busy_pin 23, busy_pull_up true).

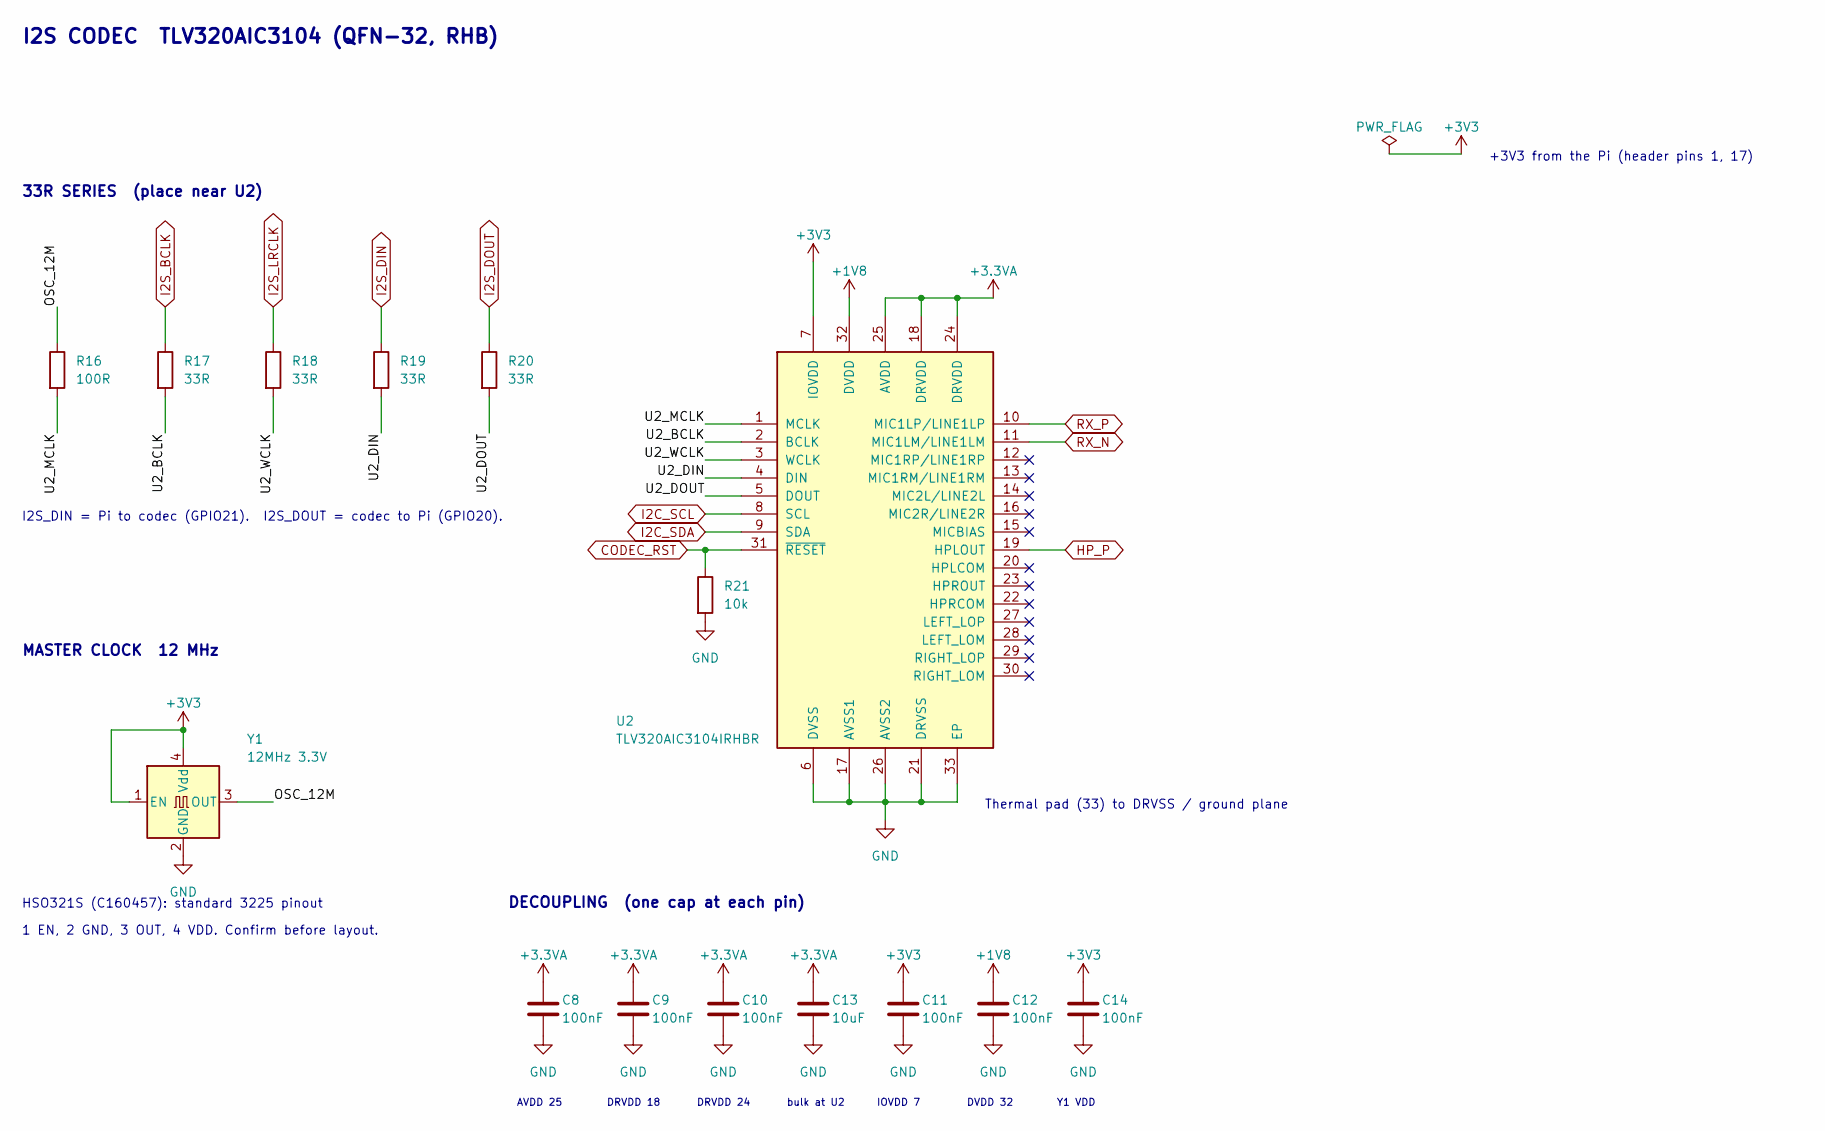
[picture p26: schematic codec.kicad_sch]

Parts:
C8, C9, C10, C11, C12, C14: 100nF; C_0603_1608Metric; LCSC C14663
C13: 10uF; C_0805_2012Metric; LCSC C95841
R16: 100R; R_0603_1608Metric; LCSC C22775
R17, R18, R19, R20: 33R; R_0603_1608Metric; LCSC C23140
R21: 10k; R_0603_1608Metric; LCSC C25804
U2: TLV320AIC3104IRHBR; QFN-32-1EP_5x5mm_P0.5mm_EP3.45x3.45mm; LCSC C181753
Y1: 12MHz 3.3V; Oscillator_SMD_Abracon_ASE-4Pin_3.2x2.5mm; LCSC C160457

Connections:
+1V8: C12.1, U2.32 (DVDD); also elsewhere on the board
+3.3VA: C8.1, C9.1, C10.1, C13.1, U2.18 (DRVDD), U2.24 (DRVDD), U2.25 (AVDD); also elsewhere on the board
+3V3: C11.1, C14.1, U2.7 (IOVDD), Y1.1 (EN), Y1.4 (Vdd); also elsewhere on the board
/Codec/OSC_12M: R16.1, Y1.3 (OUT)
/Codec/U2_BCLK: R17.2, U2.2 (BCLK)
/Codec/U2_DIN: R19.2, U2.4 (DIN)
/Codec/U2_DOUT: R20.2, U2.5 (DOUT)
/Codec/U2_MCLK: R16.2, U2.1 (MCLK)
/Codec/U2_WCLK: R18.2, U2.3 (WCLK)
CODEC_RST: R21.1, U2.31 (~RESET); also elsewhere on the board
GND: C8.2, C9.2, C10.2, C11.2, C12.2, C13.2, C14.2, R21.2, U2.6 (DVSS), U2.17 (AVSS1), U2.21 (DRVSS), U2.26 (AVSS2), U2.33 (EP), Y1.2 (GND); also elsewhere on the board
HP_P: U2.19 (HPLOUT); also elsewhere on the board
I2C_SCL: U2.8 (SCL); also elsewhere on the board
I2C_SDA: U2.9 (SDA); also elsewhere on the board
I2S_BCLK: R17.1; also elsewhere on the board
I2S_DIN: R19.1; also elsewhere on the board
I2S_DOUT: R20.1; also elsewhere on the board
I2S_LRCLK: R18.1; also elsewhere on the board
RX_N: U2.11 (MIC1LM/LINE1LM); also elsewhere on the board
RX_P: U2.10 (MIC1LP/LINE1LP); also elsewhere on the board

Notes on the sheet:
I2S CODEC TLV320AIC3104 (QFN-32, RHB)
Thermal pad (33) to DRVSS / ground plane
33R SERIES (place near U2)
I2S_DIN = Pi to codec (GPIO21). I2S_DOUT = codec to Pi (GPIO20).
MASTER CLOCK 12 MHz
HSO321S (C160457): standard 3225 pinout
1 EN, 2 GND, 3 OUT, 4 VDD. Confirm before layout.
DECOUPLING (one cap at each pin)
AVDD 25
DRVDD 18
DRVDD 24
bulk at U2
IOVDD 7
DVDD 32
Y1 VDD
+3V3 from the Pi (header pins 1, 17)

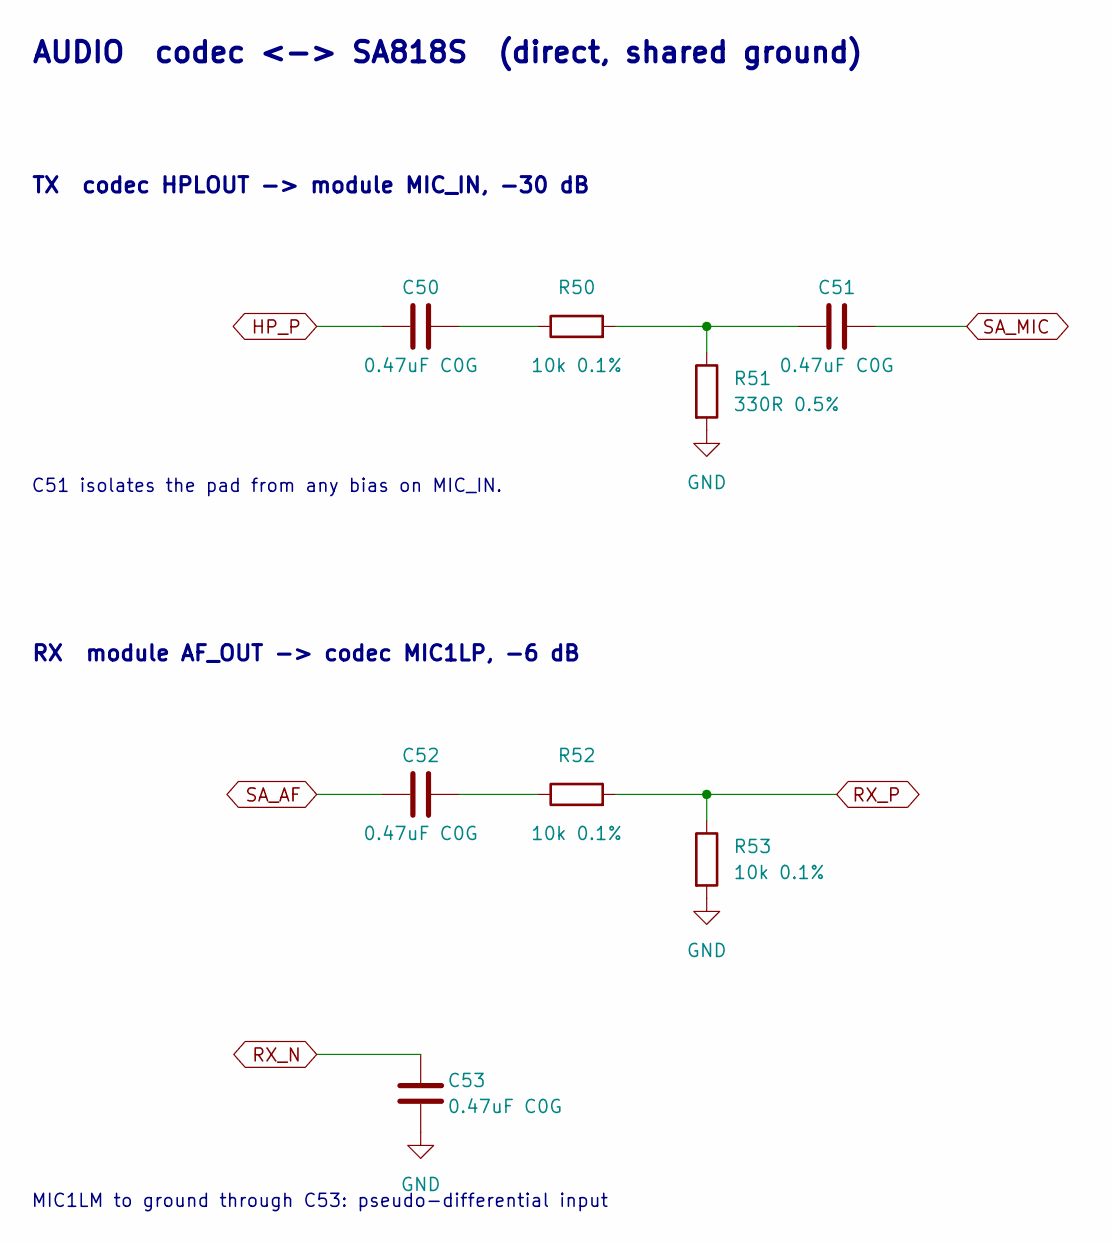
[picture p27: schematic audio.kicad_sch]

Parts:
C50, C51, C52, C53: 0.47uF C0G; C_1206_3216Metric; LCSC C6049896
R50, R52, R53: 10k 0.1%; R_0603_1608Metric; LCSC C95204
R51: 330R 0.5%; R_0603_1608Metric; LCSC C723588

Connections:
GND: C53.2, R51.2, R53.2; also elsewhere on the board
HP_P: C50.1; also elsewhere on the board
unnamed: C50.2, R50.1
unnamed: C51.1, R50.2, R51.1
unnamed: C52.2, R52.1
RX_N: C53.1; also elsewhere on the board
RX_P: R52.2, R53.1; also elsewhere on the board
SA_AF: C52.1; also elsewhere on the board
SA_MIC: C51.2; also elsewhere on the board

Notes on the sheet:
AUDIO codec <-> SA818S (direct, shared ground)
TX codec HPLOUT -> module MIC_IN, -30 dB
C51 isolates the pad from any bias on MIC_IN.
RX module AF_OUT -> codec MIC1LP, -6 dB
MIC1LM to ground through C53: pseudo-differential input

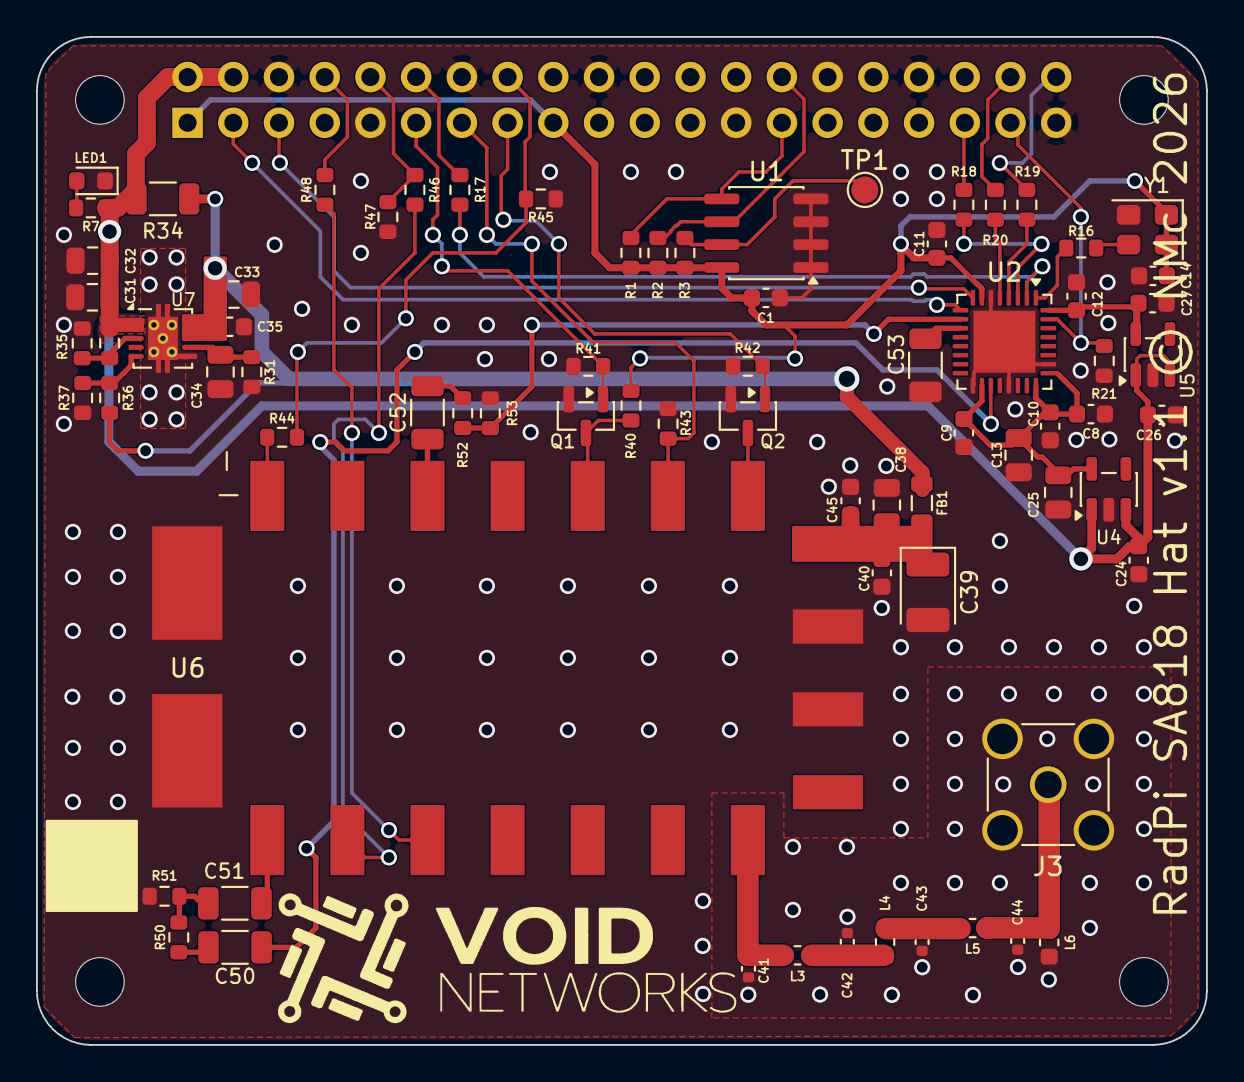
[picture p28: board sa818s-hat.kicad_pcb from above]

Board: 2 copper layers, 65.0 x 56.0 mm, 80 parts (1 on the bottom side), 50 nets.

Other parts of the board:
MH1, MH2, MH3, MH4: MountingHole_2.7mm_M2.5
