nm4c/radio-remote/pihat/pihat.kicad_pcb

## KiCad design pihat/pihat.kicad_pcb (2026-11-12)

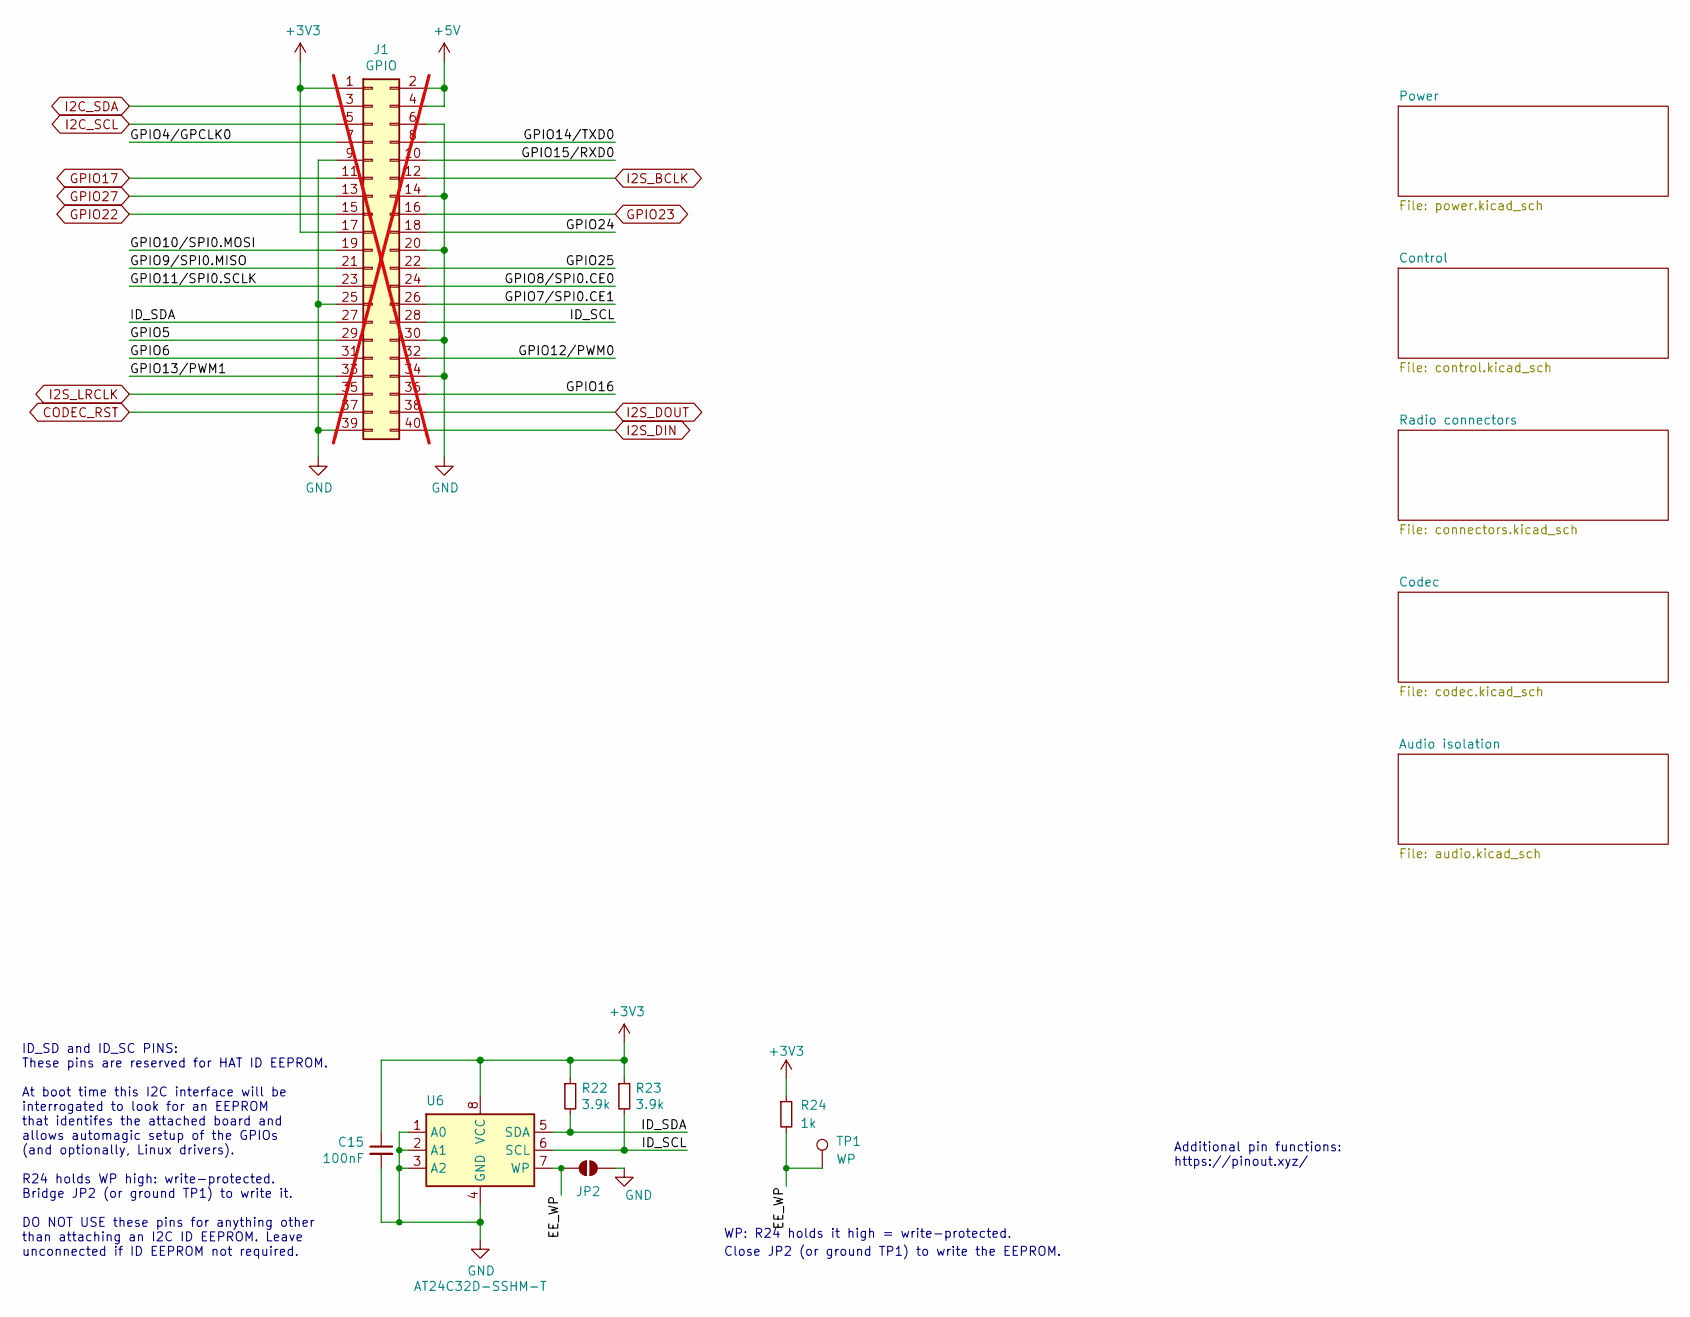
[picture p29: schematic pihat.kicad_sch]

Parts:
C15: 100nF; C_0603_1608Metric; LCSC C14663
J1: GPIO; PinSocket_2x20_P2.54mm_Vertical; LCSC C2977589; not fitted
JP2: WP write enable; SolderJumper-2_P1.3mm_Open_RoundedPad1.0x1.5mm
R22, R23: 3.9k; R_0603_1608Metric; LCSC C23018
R24: 1k; R_0603_1608Metric; LCSC C21190
TP1: WP; TestPoint_Pad_D1.5mm
U6: AT24C32D-SSHM-T; SOIC-8_3.9x4.9mm_P1.27mm; LCSC C60583

Connections:
+3V3: C15.1, J1.1, J1.17, R22.1, R23.1, R24.1, U6.8 (VCC); also elsewhere on the board
+5V: J1.2, J1.4; also elsewhere on the board
/EE_WP: JP2.1 (A), R24.2, TP1.1 (1_1), U6.7 (WP)
/GPIO4/GPCLK0: J1.7
/GPIO5: J1.29
/GPIO6: J1.31
/GPIO7/SPI0.CE1: J1.26
/GPIO8/SPI0.CE0: J1.24
/GPIO9/SPI0.MISO: J1.21
/GPIO10/SPI0.MOSI: J1.19
/GPIO11/SPI0.SCLK: J1.23
/GPIO12/PWM0: J1.32
/GPIO13/PWM1: J1.33
/GPIO14/TXD0: J1.8
/GPIO15/RXD0: J1.10
/GPIO16: J1.36
/GPIO24: J1.18
/GPIO25: J1.22
/ID_SCL: J1.28, R23.2, U6.6 (SCL)
/ID_SDA: J1.27, R22.2, U6.5 (SDA)
CODEC_RST: J1.37; also elsewhere on the board
GND: C15.2, J1.6, J1.9, J1.14, J1.20, J1.25, J1.30, J1.34, J1.39, JP2.2 (B), U6.1 (A0), U6.2 (A1), U6.3 (A2), U6.4 (GND); also elsewhere on the board
GPIO17: J1.11; also elsewhere on the board
GPIO22: J1.15; also elsewhere on the board
GPIO23: J1.16; also elsewhere on the board
GPIO27: J1.13; also elsewhere on the board
I2C_SCL: J1.5; also elsewhere on the board
I2C_SDA: J1.3; also elsewhere on the board
I2S_BCLK: J1.12; also elsewhere on the board
I2S_DIN: J1.40; also elsewhere on the board
I2S_DOUT: J1.38; also elsewhere on the board
I2S_LRCLK: J1.35; also elsewhere on the board

Notes on the sheet:
Additional pin functions: https://pinout.xyz/
ID_SD and ID_SC PINS: These pins are reserved for HAT ID EEPROM. At boot time this I2C interface will be interrogated to look for an EEPROM that identifes the attached board and allows automagic setup of the GPIOs (and optionally, Linux drivers). R24 holds WP high: write-protected. Bridge JP2 (or g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
WP: R24 holds it high = write-protected.
Close JP2 (or ground TP1) to write the EEPROM.
