nm4c/radio-remote/pihat/pihat.kicad_pcb

## KiCad design pihat/pihat.kicad_pcb (continued)

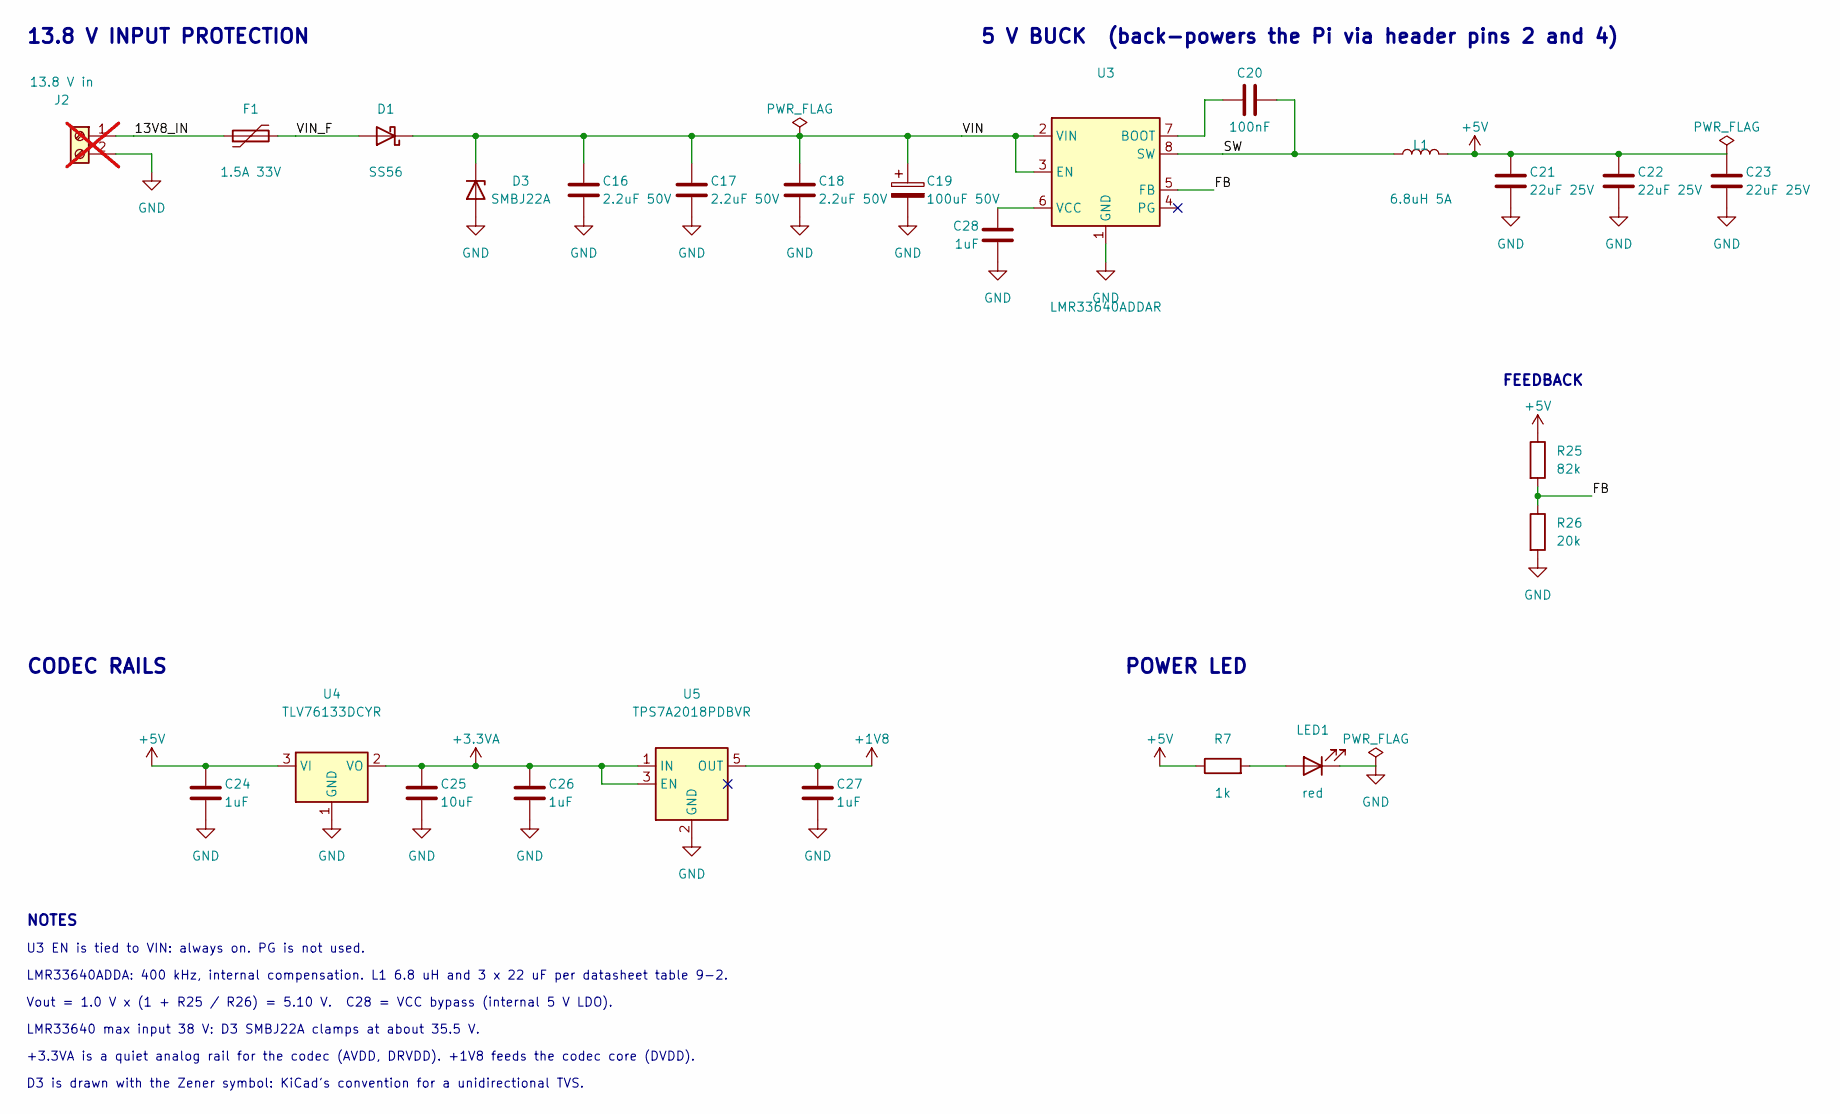
[picture p30: schematic power.kicad_sch]

Parts:
C16, C17, C18: 2.2uF 50V; C_1206_3216Metric; LCSC C50254
C19: 100uF 50V; CP_Elec_8x10.5; LCSC C72480
C20: 100nF; C_0603_1608Metric; LCSC C14663
C21, C22, C23: 22uF 25V; C_1206_3216Metric; LCSC C12891
C24, C26, C27, C28: 1uF; C_0603_1608Metric; LCSC C15849
C25: 10uF; C_0805_2012Metric; LCSC C15850
D1: SS56; D_SMA; LCSC C65009
D3: SMBJ22A; D_SMB; LCSC C224015
F1: 1.5A 33V; Fuse_1812_4532Metric; LCSC C18198333
J2: 13.8 V in; Xinlaiya_XY2500V-F-3.5_1x02_P3.50mm_Vertical; LCSC C880554; not fitted
L1: 6.8uH 5A; L_Changjiang_FXL0630; LCSC C167221
LED1: red; LED_0603_1608Metric; LCSC C2286
R7: 1k; R_0603_1608Metric; LCSC C21190
R25: 82k; R_0603_1608Metric; LCSC C23254
R26: 20k; R_0603_1608Metric; LCSC C4184
U3: LMR33640ADDAR; Texas_HSOP-8-1EP_3.9x4.9mm_P1.27mm_ThermalVias; LCSC C2836966
U4: TLV76133DCYR; SOT-223-3_TabPin2; LCSC C7527500
U5: TPS7A2018PDBVR; SOT-23-5; LCSC C963430

Connections:
+1V8: C27.1, U5.5 (OUT); also elsewhere on the board
+3.3VA: C25.1, C26.1, U4.2 (VO), U5.1 (IN), U5.3 (EN); also elsewhere on the board
+5V: C21.1, C22.1, C23.1, C24.1, L1.2, R7.1, R25.1, U4.3 (VI); also elsewhere on the board
/Power/13V8_IN: F1.1, J2.1
/Power/FB: R25.2, R26.1, U3.5 (FB)
/Power/SW: C20.2, L1.1, U3.8 (SW)
/Power/VIN: C16.1, C17.1, C18.1, C19.1, D1.1 (K), D3.1 (K), U3.2 (VIN), U3.3 (EN)
/Power/VIN_F: D1.2 (A), F1.2
GND: C16.2, C17.2, C18.2, C19.2, C21.2, C22.2, C23.2, C24.2, C25.2, C26.2, C27.2, C28.2, D3.2 (A), J2.2, LED1.1 (K), R26.2, U3.1 (GND), U3.9 (GND), U4.1 (GND), U5.2 (GND); also elsewhere on the board
unnamed: LED1.2 (A), R7.2
unnamed: C20.1, U3.7 (BOOT)
unnamed: C28.1, U3.6 (VCC)

Notes on the sheet:
13.8 V INPUT PROTECTION
5 V BUCK (back-powers the Pi via header pins 2 and 4)
FEEDBACK
CODEC RAILS
POWER LED
NOTES
U3 EN is tied to VIN: always on. PG is not used.
LMR33640ADDA: 400 kHz, internal compensation. L1 6.8 uH and 3 x 22 uF per datasheet table 9-2.
Vout = 1.0 V x (1 + R25 / R26) = 5.10 V. C28 = VCC bypass (internal 5 V LDO).
LMR33640 max input 38 V: D3 SMBJ22A clamps at about 35.5 V.
+3.3VA is a quiet analog rail for the codec (AVDD, DRVDD). +1V8 feeds the codec core (DVDD).
D3 is drawn with the Zener symbol: KiCad's convention for a unidirectional TVS.

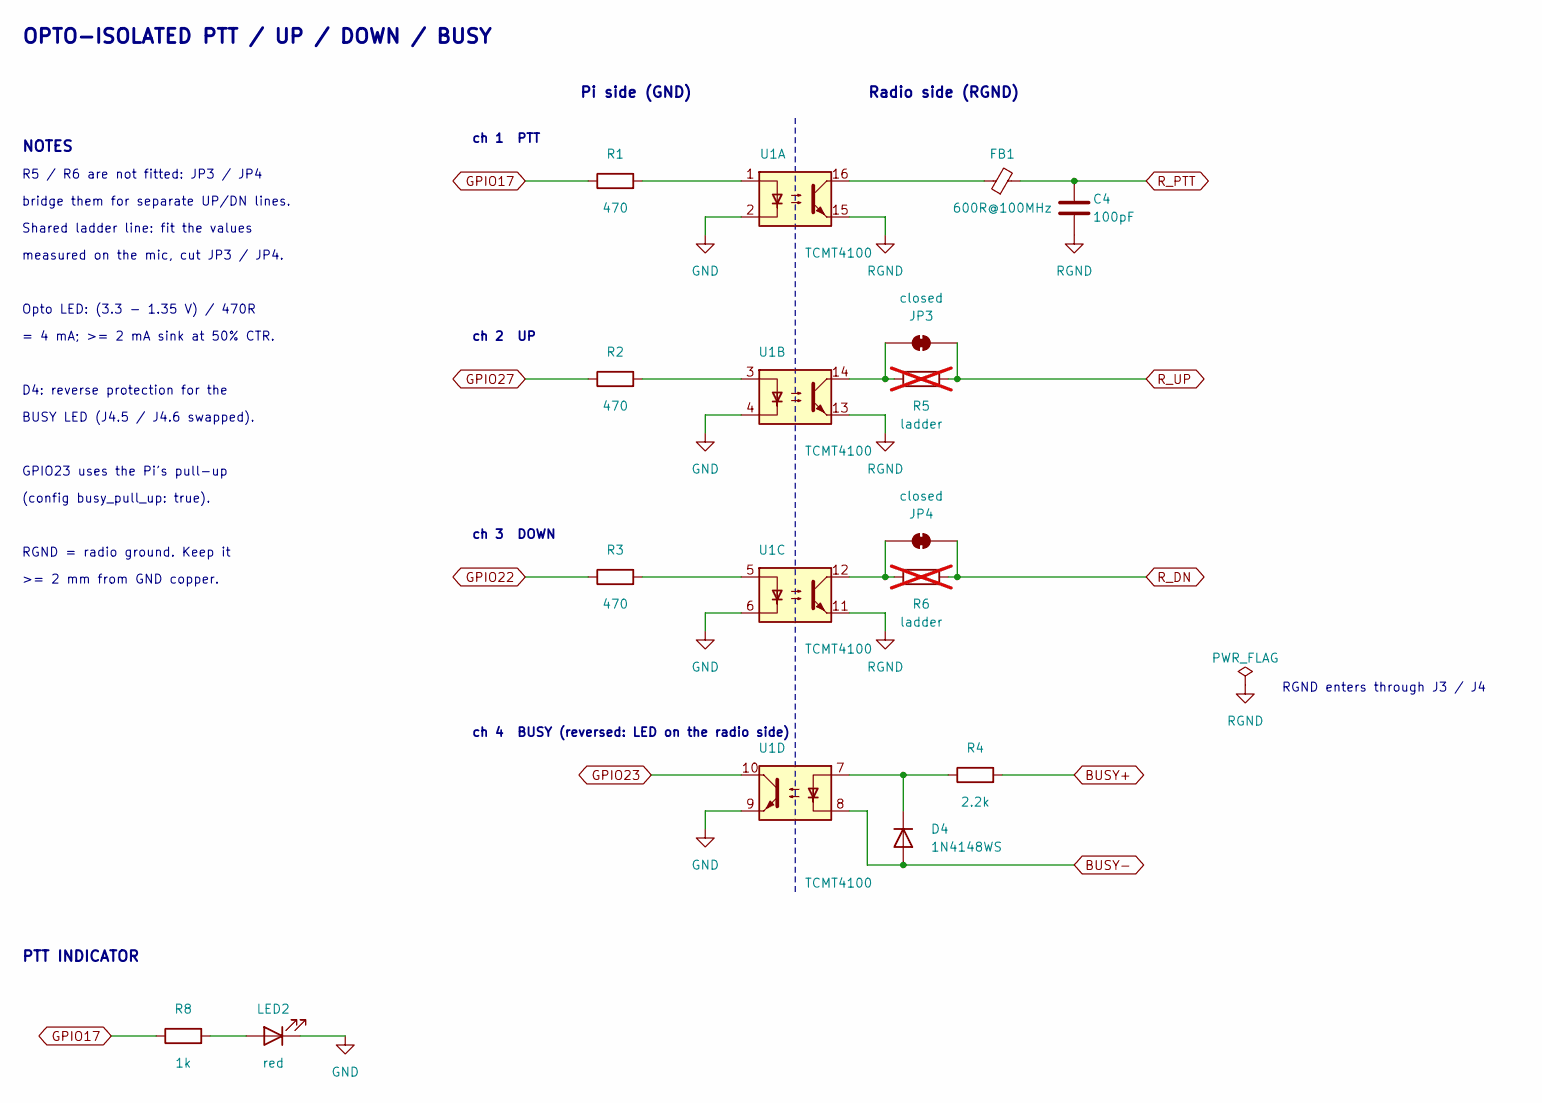
[picture p31: schematic control.kicad_sch]

Parts:
C4: 100pF; C_0603_1608Metric; LCSC C14858
D4: 1N4148WS; D_SOD-323; LCSC C2128
FB1: 600R@100MHz; L_0603_1608Metric; LCSC C1002
JP3, JP4: closed; SolderJumper-2_P1.3mm_Bridged_RoundedPad1.0x1.5mm
LED2: red; LED_0603_1608Metric; LCSC C2286
R1, R2, R3: 470; R_0603_1608Metric; LCSC C23179
R4: 2.2k; R_0603_1608Metric; LCSC C4190
R5, R6: ladder; R_0603_1608Metric; not fitted
R8: 1k; R_0603_1608Metric; LCSC C21190
U1: TCMT4100; SOP-16_4.4x10.4mm_P1.27mm; LCSC C2938669

Connections:
BUSY+: R4.2; also elsewhere on the board
BUSY-: D4.2 (A), U1.8; also elsewhere on the board
GND: LED2.1 (K), U1.2, U1.4, U1.6, U1.9; also elsewhere on the board
GPIO17: R1.1, R8.1; also elsewhere on the board
GPIO22: R3.1; also elsewhere on the board
GPIO23: U1.10; also elsewhere on the board
GPIO27: R2.1; also elsewhere on the board
unnamed: D4.1 (K), R4.1, U1.7
unnamed: FB1.1, U1.16
unnamed: JP3.1 (A), R5.1, U1.14
unnamed: JP4.1 (A), R6.1, U1.12
unnamed: LED2.2 (A), R8.2
unnamed: R1.2, U1.1
unnamed: R2.2, U1.3
unnamed: R3.2, U1.5
RGND: C4.2, U1.11, U1.13, U1.15; also elsewhere on the board
R_DN: JP4.2 (B), R6.2; also elsewhere on the board
R_PTT: C4.1, FB1.2; also elsewhere on the board
R_UP: JP3.2 (B), R5.2; also elsewhere on the board

Notes on the sheet:
OPTO-ISOLATED PTT / UP / DOWN / BUSY
Pi side (GND)
Radio side (RGND)
ch 1 PTT
ch 2 UP
ch 3 DOWN
ch 4 BUSY (reversed: LED on the radio side)
RGND enters through J3 / J4
PTT INDICATOR
NOTES
R5 / R6 are not fitted: JP3 / JP4
bridge them for separate UP/DN lines.
Shared ladder line: fit the values
measured on the mic, cut JP3 / JP4.
Opto LED: (3.3 - 1.35 V) / 470R
= 4 mA; >= 2 mA sink at 50% CTR.
D4: reverse protection for the
BUSY LED (J4.5 / J4.6 swapped).
GPIO23 uses the Pi's pull-up
(config busy_pull_up: true).
RGND = radio ground. Keep it
>= 2 mm from GND copper.

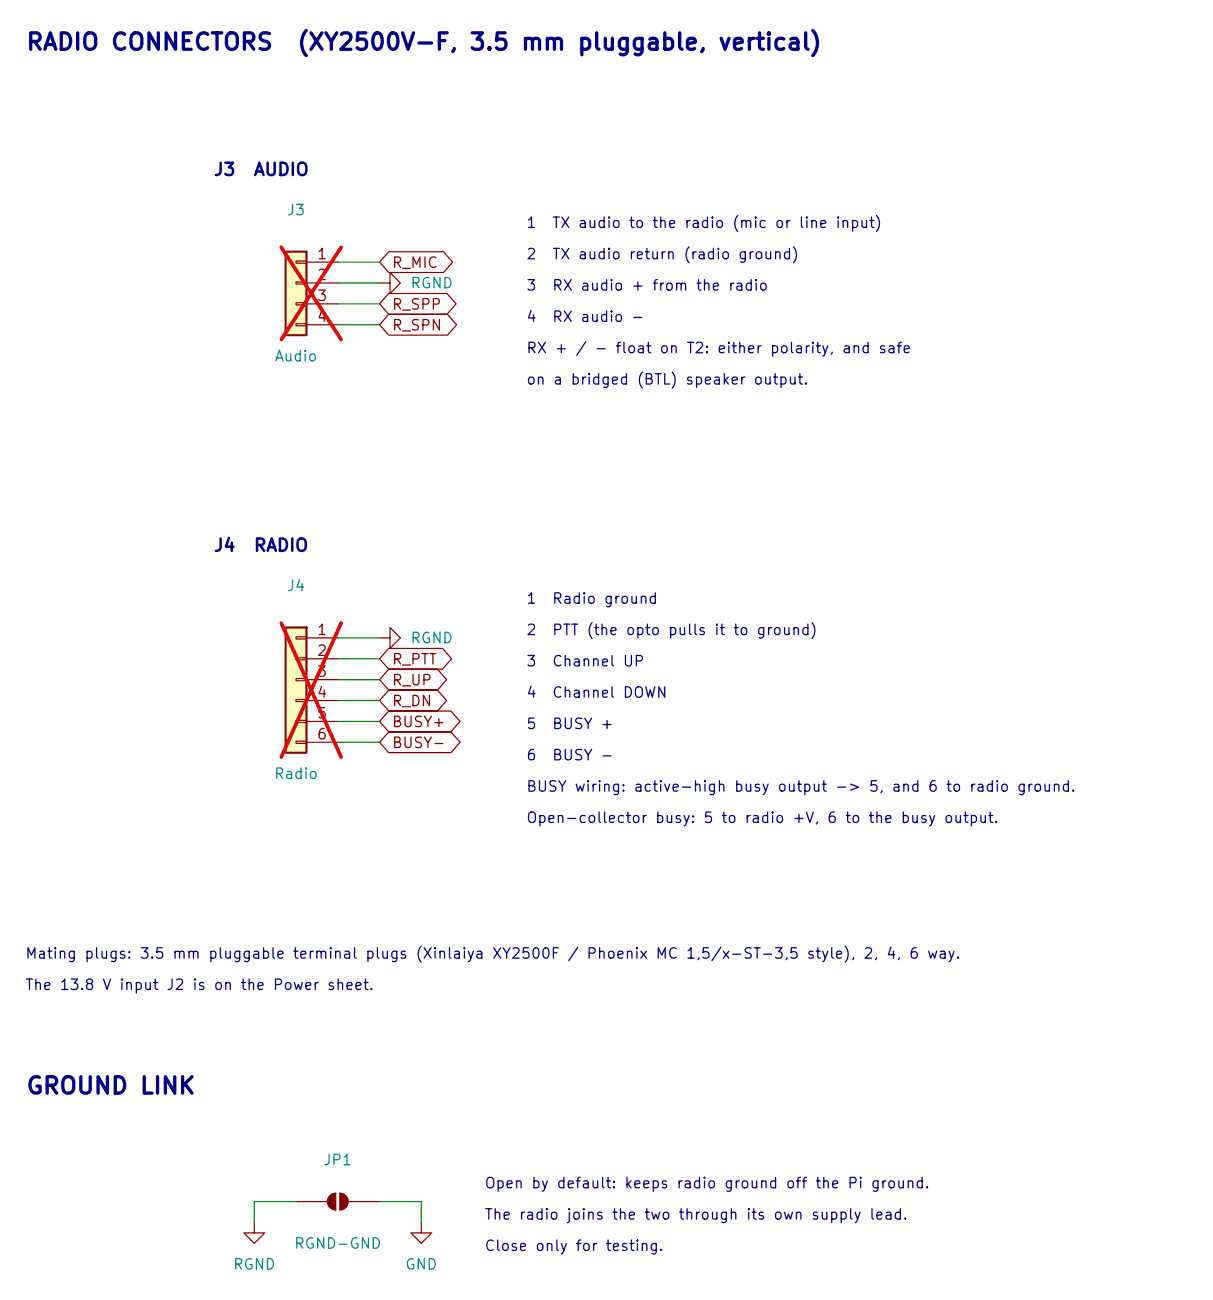
[picture p32: schematic connectors.kicad_sch, Radio connectors]

Parts:
J3: Audio; Xinlaiya_XY2500V-F-3.5_1x04_P3.50mm_Vertical; LCSC C880556; not fitted
J4: Radio; Xinlaiya_XY2500V-F-3.5_1x06_P3.50mm_Vertical; LCSC C880558; not fitted
JP1: RGND-GND; SolderJumper-2_P1.3mm_Open_RoundedPad1.0x1.5mm

Connections:
BUSY+: J4.5; also elsewhere on the board
BUSY-: J4.6; also elsewhere on the board
GND: JP1.2 (B); also elsewhere on the board
RGND: J3.2, J4.1, JP1.1 (A); also elsewhere on the board
R_DN: J4.4; also elsewhere on the board
R_MIC: J3.1; also elsewhere on the board
R_PTT: J4.2; also elsewhere on the board
R_SPN: J3.4; also elsewhere on the board
R_SPP: J3.3; also elsewhere on the board
R_UP: J4.3; also elsewhere on the board

Notes on the sheet:
RADIO CONNECTORS (XY2500V-F, 3.5 mm pluggable, vertical)
J3 AUDIO
1 TX audio to the radio (mic or line input)
2 TX audio return (radio ground)
3 RX audio + from the radio
4 RX audio -
RX + / - float on T2: either polarity, and safe
on a bridged (BTL) speaker output.
J4 RADIO
1 Radio ground
2 PTT (the opto pulls it to ground)
3 Channel UP
4 Channel DOWN
5 BUSY +
6 BUSY -
BUSY wiring: active-high busy output -> 5, and 6 to radio ground.
Open-collector busy: 5 to radio +V, 6 to the busy output.
Mating plugs: 3.5 mm pluggable terminal plugs (Xinlaiya XY2500F / Phoenix MC 1,5/x-ST-3,5 style), 2, 4, 6 way.
The 13.8 V input J2 is on the Power sheet.
GROUND LINK
Open by default: keeps radio ground off the Pi ground.
The radio joins the two through its own supply lead.
Close only for testing.

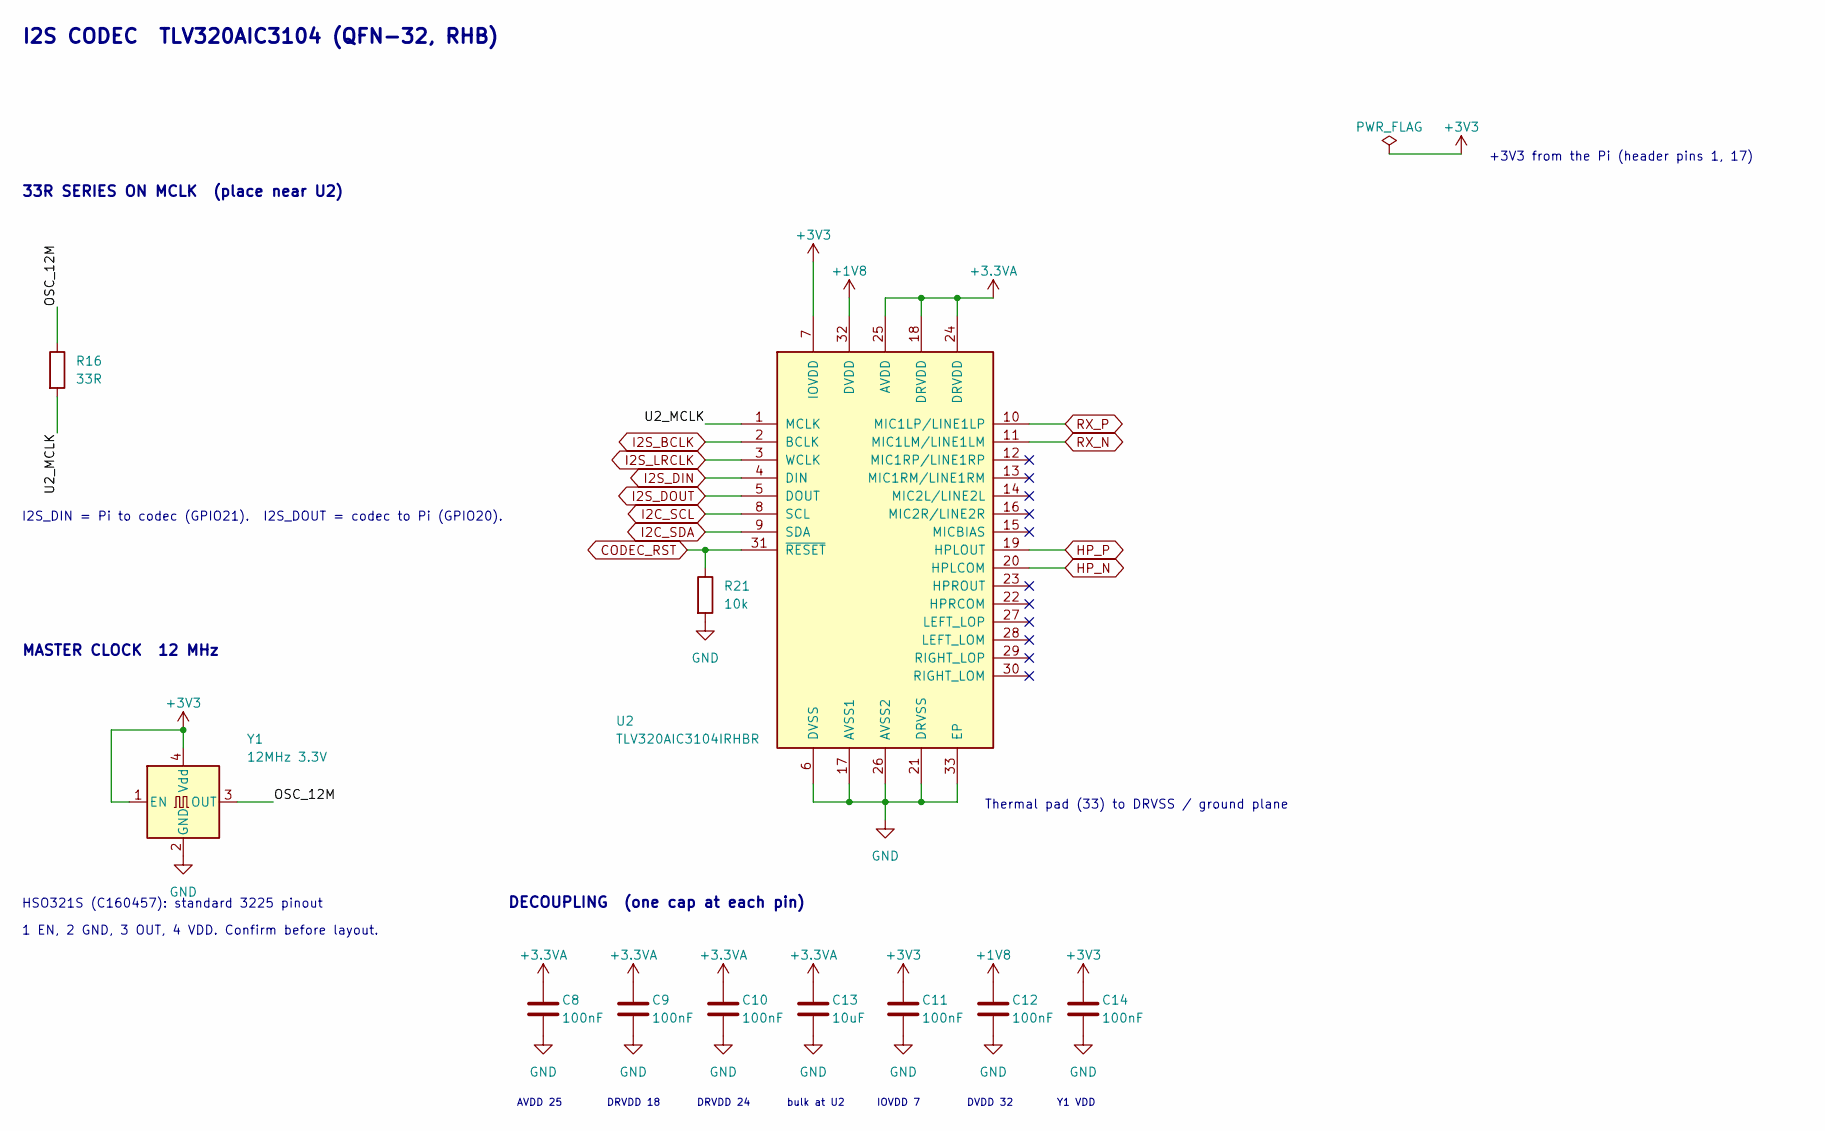
[picture p33: schematic codec.kicad_sch]

Parts:
C8, C9, C10, C11, C12, C14: 100nF; C_0603_1608Metric; LCSC C14663
C13: 10uF; C_0805_2012Metric; LCSC C15850
R16: 33R; R_0603_1608Metric; LCSC C23140
R21: 10k; R_0603_1608Metric; LCSC C25804
U2: TLV320AIC3104IRHBR; QFN-32-1EP_5x5mm_P0.5mm_EP3.45x3.45mm; LCSC C181753
Y1: 12MHz 3.3V; Oscillator_SMD_Abracon_ASE-4Pin_3.2x2.5mm; LCSC C160457

Connections:
+1V8: C12.1, U2.32 (DVDD); also elsewhere on the board
+3.3VA: C8.1, C9.1, C10.1, C13.1, U2.18 (DRVDD), U2.24 (DRVDD), U2.25 (AVDD); also elsewhere on the board
+3V3: C11.1, C14.1, U2.7 (IOVDD), Y1.1 (EN), Y1.4 (Vdd); also elsewhere on the board
/Codec/OSC_12M: R16.1, Y1.3 (OUT)
/Codec/U2_MCLK: R16.2, U2.1 (MCLK)
CODEC_RST: R21.1, U2.31 (~RESET); also elsewhere on the board
GND: C8.2, C9.2, C10.2, C11.2, C12.2, C13.2, C14.2, R21.2, U2.6 (DVSS), U2.17 (AVSS1), U2.21 (DRVSS), U2.26 (AVSS2), U2.33 (EP), Y1.2 (GND); also elsewhere on the board
HP_N: U2.20 (HPLCOM); also elsewhere on the board
HP_P: U2.19 (HPLOUT); also elsewhere on the board
I2C_SCL: U2.8 (SCL); also elsewhere on the board
I2C_SDA: U2.9 (SDA); also elsewhere on the board
I2S_BCLK: U2.2 (BCLK); also elsewhere on the board
I2S_DIN: U2.4 (DIN); also elsewhere on the board
I2S_DOUT: U2.5 (DOUT); also elsewhere on the board
I2S_LRCLK: U2.3 (WCLK); also elsewhere on the board
RX_N: U2.11 (MIC1LM/LINE1LM); also elsewhere on the board
RX_P: U2.10 (MIC1LP/LINE1LP); also elsewhere on the board

Notes on the sheet:
I2S CODEC TLV320AIC3104 (QFN-32, RHB)
Thermal pad (33) to DRVSS / ground plane
33R SERIES ON MCLK (place near U2)
I2S_DIN = Pi to codec (GPIO21). I2S_DOUT = codec to Pi (GPIO20).
MASTER CLOCK 12 MHz
HSO321S (C160457): standard 3225 pinout
1 EN, 2 GND, 3 OUT, 4 VDD. Confirm before layout.
DECOUPLING (one cap at each pin)
AVDD 25
DRVDD 18
DRVDD 24
bulk at U2
IOVDD 7
DVDD 32
Y1 VDD
+3V3 from the Pi (header pins 1, 17)

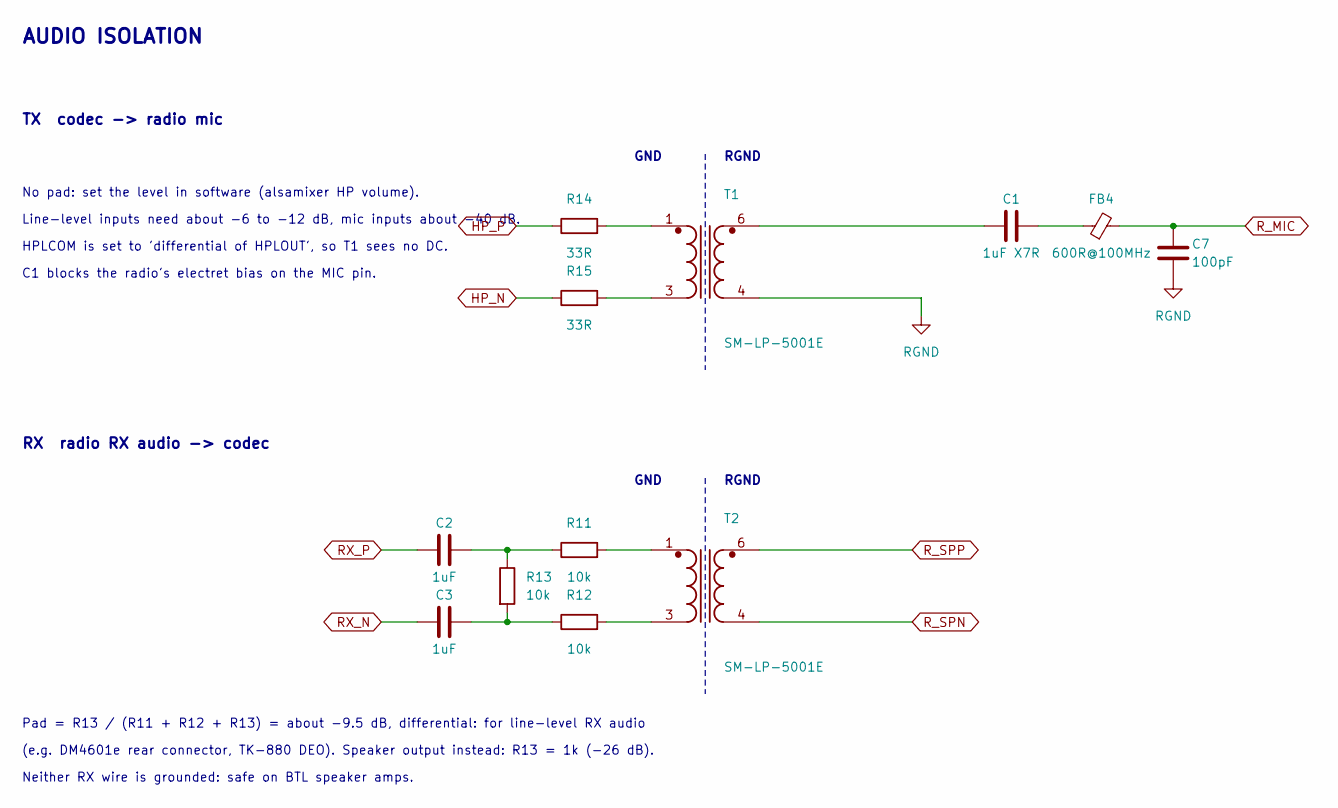
[picture p34: schematic audio.kicad_sch, Audio isolation]

Parts:
C1: 1uF X7R; C_0805_2012Metric; LCSC C28323
C2, C3: 1uF; C_0603_1608Metric; LCSC C15849
C7: 100pF; C_0603_1608Metric; LCSC C14858
FB4: 600R@100MHz; L_0603_1608Metric; LCSC C1002
R11, R12, R13: 10k; R_0603_1608Metric; LCSC C25804
R14, R15: 33R; R_0603_1608Metric; LCSC C23140
T1, T2: SM-LP-5001E; Bourns_SM-LP-5001; LCSC C840532

Connections:
HP_N: R15.1; also elsewhere on the board
HP_P: R14.1; also elsewhere on the board
unnamed: C1.1, T1.6
unnamed: C1.2, FB4.1
unnamed: C2.2, R11.1, R13.1
unnamed: C3.2, R12.1, R13.2
unnamed: R11.2, T2.1
unnamed: R12.2, T2.3
unnamed: R14.2, T1.1
unnamed: R15.2, T1.3
RGND: C7.2, T1.4; also elsewhere on the board
RX_N: C3.1; also elsewhere on the board
RX_P: C2.1; also elsewhere on the board
R_MIC: C7.1, FB4.2; also elsewhere on the board
R_SPN: T2.4; also elsewhere on the board
R_SPP: T2.6; also elsewhere on the board

Notes on the sheet:
AUDIO ISOLATION
TX codec -> radio mic
GND
RGND
No pad: set the level in software (alsamixer HP volume).
Line-level inputs need about -6 to -12 dB, mic inputs about -40 dB.
HPLCOM is set to 'differential of HPLOUT', so T1 sees no DC.
C1 blocks the radio's electret bias on the MIC pin.
RX radio RX audio -> codec
Pad = R13 / (R11 + R12 + R13) = about -9.5 dB, differential: for line-level RX audio
(e.g. DM4601e rear connector, TK-880 DEO). Speaker output instead: R13 = 1k (-26 dB).
Neither RX wire is grounded: safe on BTL speaker amps.

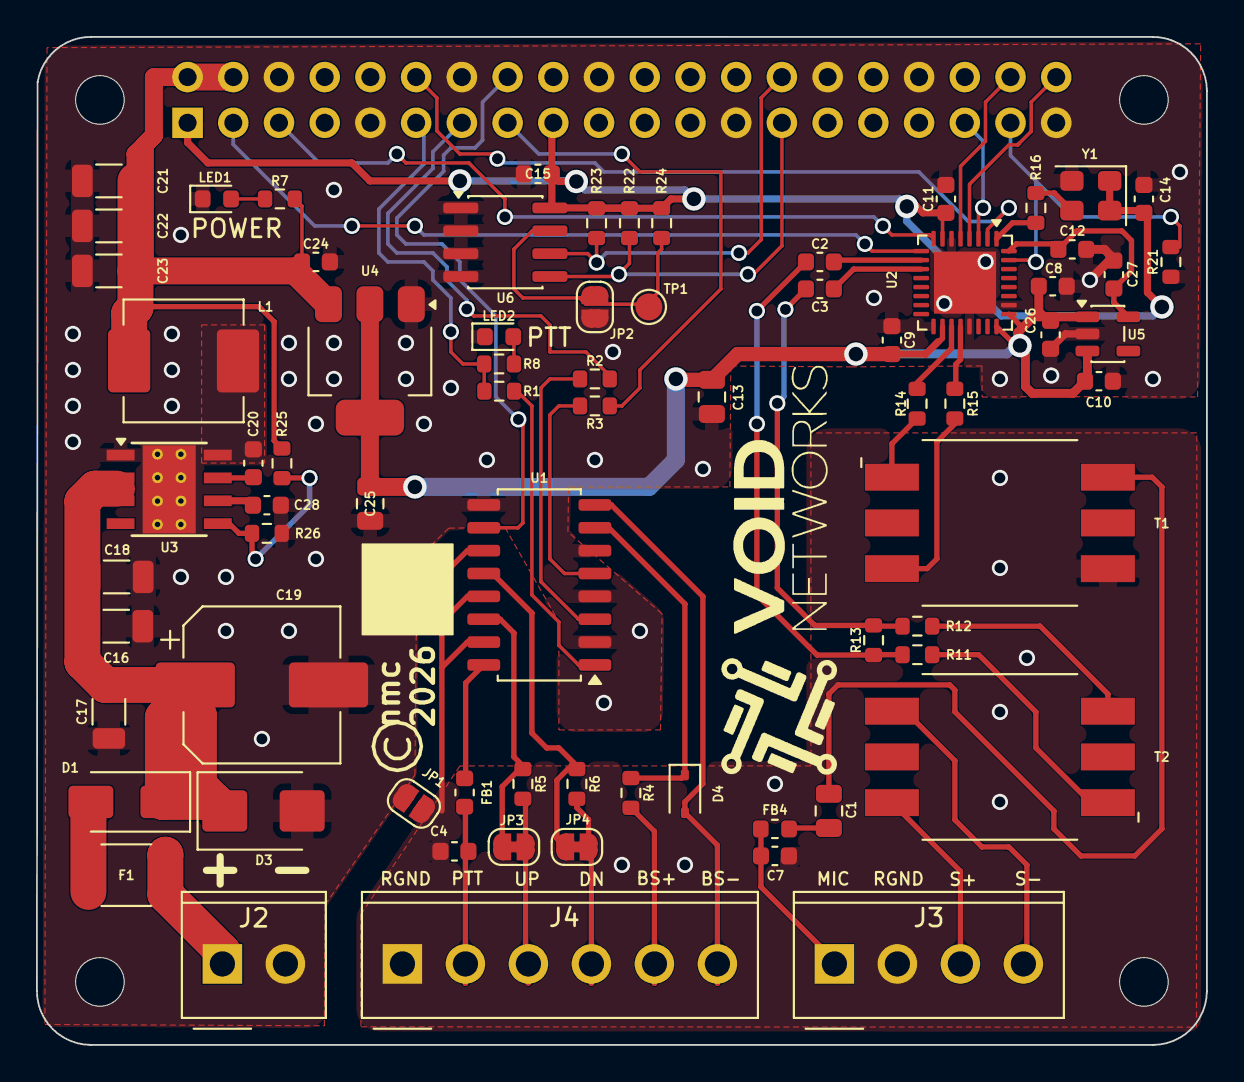
[picture p35: board pihat.kicad_pcb from above]

Board: 2 copper layers, 65.0 x 56.0 mm, 77 parts (1 on the bottom side), 58 nets.

Other parts of the board:
MH1, MH2, MH3, MH4: MountingHole_2.7mm_M2.5
