nm4c/radio-remote/pihat/tools/kicad/verify.py

"""Compare KiCad's exported netlist with the intended connections.

Expected nets are listed as sets of REF.PIN. A net matches if KiCad has a net
containing exactly those pins among the refs we check (extra pins on shared
nets like GND/+5V that belong to other sheets are ignored).
"""
import os
import sys

import os as _os, sys as _sys
_sys.path.insert(0, _os.path.join(_os.path.dirname(_os.path.abspath(__file__)), "..", "..", "..", "kicadgen"))
from sexp import find, find_all, parse

HERE = os.path.dirname(os.path.abspath(__file__))
NET = os.path.join(os.environ.get("PIHAT_PROJ") or os.path.join(HERE, "..", ".."), "build", "pihat.net")

POWER = {
    "13V8_IN": "J2.1 F1.1",
    "VIN_F": "F1.2 D1.2",
    "VIN": "D1.1 D3.1 C16.1 C17.1 C18.1 C19.1 U3.2 U3.3",     # EN tied to VIN
    "VCC": "U3.6 C28.1",
    "BOOT": "U3.7 C20.1",
    "SW": "U3.8 C20.2 L1.1",
    "+5V": "L1.2 C21.1 C22.1 C23.1 R25.1 U4.3 C24.1 R7.1",
    "FB": "U3.5 R25.2 R26.1",
    "+3.3VA": "U4.2 C25.1 C26.1 U5.1 U5.3",
    "+1V8": "U5.5 C27.1",
    "LED": "R7.2 LED1.2",
    "GND": "J2.2 D3.2 C16.2 C17.2 C18.2 C19.2 U3.1 U3.9 C28.2 C21.2 C22.2 C23.2 R26.2 "
           "U4.1 C24.2 C25.2 C26.2 U5.2 C27.2 LED1.1",
}
CONTROL = {
    "GPIO17": "R1.1 R8.1 J1.11",
    "OPTO_A1": "R1.2 U1.1",
    "GPIO27": "R2.1 J1.13",
    "OPTO_A2": "R2.2 U1.3",
    "GPIO22": "R3.1 J1.15",
    "OPTO_A3": "R3.2 U1.5",
    "PTT_C": "U1.16 FB1.1",
    "R_PTT": "FB1.2 C4.1",
    "UP_C": "U1.14 R5.1 JP3.1",
    "R_UP": "R5.2 JP3.2",
    "DN_C": "U1.12 R6.1 JP4.1",
    "R_DN": "R6.2 JP4.2",
    "BUSY+": "R4.2",
    "OPTO_A4": "U1.7 R4.1 D4.1",
    "BUSY-": "U1.8 D4.2",
    "GPIO23": "U1.10 J1.16",
    "LED2_A": "R8.2 LED2.2",
    "RGND": "U1.15 U1.13 U1.11 C4.2",
    "GND": "U1.2 U1.4 U1.6 U1.9 LED2.1",
}
ROOT = {
    "+5V": "J1.2 J1.4",                                   # HAT back-powers the Pi
    "GND": "J1.6 J1.9 J1.14 J1.20 J1.25 J1.30 J1.34 J1.39 U6.4 U6.1 U6.2 U6.3 JP2.2 C15.2",
    "ID_SD": "U6.5 R22.2 J1.27",
    "ID_SC": "U6.6 R23.2 J1.28",
    "EE_WP": "U6.7 JP2.1 R24.2 TP1.1",
    "+3V3": "U6.8 R22.1 R23.1 C15.1 R24.1",
}
CONNECTORS = {
    "R_MIC": "J3.1",
    "RGND": "J3.2 J4.1 JP1.1",
    "R_SPP": "J3.3",
    "R_SPN": "J3.4",
    "R_PTT": "J4.2",
    "R_UP": "J4.3",
    "R_DN": "J4.4",
    "BUSY+": "J4.5",
    "BUSY-": "J4.6",
    "GND": "JP1.2",
}
CODEC = {
    "I2C_SCL": "U2.8 J1.5",
    "I2C_SDA": "U2.9 J1.3",
    "CODEC_RST": "U2.31 R21.1 J1.37",
    "OSC_12M": "Y1.3 R16.1",
    "U2_MCLK": "R16.2 U2.1",
    "I2S_BCLK": "U2.2 J1.12",                 # no series resistors on I2S
    "I2S_LRCLK": "U2.3 J1.35",
    "I2S_DIN": "U2.4 J1.40",
    "I2S_DOUT": "U2.5 J1.38",
    "+3V3": "U2.7 Y1.4 Y1.1 C11.1 C14.1 J1.1 J1.17 U6.8",
    "+1V8": "U2.32 C12.1",
    "+3.3VA": "U2.25 U2.18 U2.24 C8.1 C9.1 C10.1 C13.1",
    "GND": "U2.6 U2.17 U2.26 U2.21 U2.33 R21.2 Y1.2 C8.2 C9.2 C10.2 C11.2 C12.2 C13.2 C14.2",
    "RX_P": "U2.10 C2.1",
    "RX_N": "U2.11 C3.1",
    "HP_P": "U2.19 R14.1",
    "HP_N": "U2.20 R15.1",
}
AUDIO = {
    "T1_1": "R14.2 T1.1",
    "T1_3": "R15.2 T1.3",
    "T1_6": "T1.6 C1.1",                      # no TX pad
    "C1_FB4": "C1.2 FB4.1",
    "R_MIC": "FB4.2 C7.1",
    "RGND": "T1.4 C7.2",
    "R_SPP": "T2.6",                          # no RX ferrites
    "R_SPN": "T2.4",
    "T2_1": "T2.1 R11.2",
    "RXP": "R11.1 R13.1 C2.2",
    "T2_3": "T2.3 R12.2",
    "RXN": "R12.1 R13.2 C3.2",
}
SHEETS = {"root": ROOT, "power": POWER, "control": CONTROL, "connectors": CONNECTORS, "codec": CODEC, "audio": AUDIO}
NC = {"U3.4", "U5.4", "T1.2", "T1.5", "T2.2", "T2.5"} | {f"U2.{n}" for n in (12, 13, 14, 15, 16, 22, 23, 27, 28, 29, 30)}
NAMED = {"RGND": "U1.15", "GND": "U1.2"}   # these nets must carry exactly this name


def load():
    tree = parse(open(NET).read())
    nets = {}
    for n in find_all(find(tree, "nets"), "net"):
        name = str(find(n, "name")[1])
        nets[name] = {f"{find(x, 'ref')[1]}.{find(x, 'pin')[1]}" for x in find_all(n, "node")}
    return nets


def merged(names):
    out = {}
    for n in names:
        for k, v in SHEETS[n].items():
            out[k] = (out[k] + " " + v) if k in out else v
    return out


def main(expected=None, nc=NC):
    expected = expected or merged(SHEETS)
    nets = load()
    refs = {p.split(".")[0] for v in expected.values() for p in v.split()} | {p.split(".")[0] for p in nc}
    where = {}
    for name, pins in nets.items():
        for p in pins:
            where[p] = name
    bad = 0
    for label, members in expected.items():
        want = set(members.split())
        got_names = {where.get(p, "<missing>") for p in want}
        if len(got_names) != 1 or "<missing>" in got_names:
            print(f"FAIL {label}: pins spread over {sorted(got_names)}")
            for p in sorted(want):
                print("      ", p, "->", where.get(p, "<missing>"))
            bad += 1
            continue
        actual = {p for p in nets[got_names.pop()] if p.split(".")[0] in refs}
        if actual != want:
            print(f"FAIL {label}: extra {sorted(actual - want)} missing {sorted(want - actual)}")
            bad += 1
        else:
            print(f"ok   {label:9s} {len(want)} pins")
    for p in nc:
        n = where.get(p)
        if n and len(nets[n]) > 1:
            print(f"FAIL {p} should be unconnected but is on {n}")
            bad += 1
    for name, pin in NAMED.items():
        if where.get(pin) != name and where.get(pin) != "/" + name:
            print(f"FAIL net carrying {pin} is named {where.get(pin)!r}, expected {name!r}")
            bad += 1
    if where.get("U1.15") and where.get("U1.15") == where.get("U1.2"):
        print("FAIL RGND is merged with GND")
        bad += 1
    print("RESULT:", "all nets match" if not bad else f"{bad} problem(s)")
    return bad


if __name__ == "__main__":
    sys.exit(main())
