nm4c/radio-remote/(commit log)

2026-11-02 Add iPhone support and full wiring documentation
    - iOS: resume audio after interruptions, re-acquire mic, screen wake
    lock, reconnect on return, block long-press callout on PTT
    - Installable as a home-screen web app (manifest + icons)
    - docs/HARDWARE.md: complete Pi/GPIO/opto/audio/radio wiring guide,
    pin identification procedure, levels setup and bench tests
    - docs/wiring.svg: wiring schematic
    - gpio.busy_invert option for inverted busy signals
    [config.example.yaml, config.py, radio.py]
2026-11-02 Add Radio Remote Pi HAT project and docs
    - pihat/: KiCad project (from the RPi HAT template), README
    - pihat/docs/schematic: reference schematic page (7 sheets, netlist,
    parts, pre-layout checks) and its generator
    - pihat/docs/BOM.md + jlc-bom.csv generated from the same parts list
    - Link the HAT from the main README; ignore KiCad temp/backup files
    [jlc-bom.csv, pihat.kicad_pcb, pihat.kicad_sch]
2026-11-02 Add KiCad power sheet and schematic generator
    - pihat/power.kicad_sch: 13.8 V input protection, TPS54360 5 V buck,
    TLV76133 3.3VA and TPS7A2018 1V8 codec rails, power LED
    - Root sheet links the Power sub-sheet
    - pihat/tools/kicad: generator (stock KiCad symbols, computed pin
    endpoints), netlist verifier and ERC/SVG checks via kicad-cli
    [pihat.kicad_sch, power.kicad_sch]
2026-11-02 Add KiCad control sheet; link header GPIOs; stable UUIDs
    - pihat/control.kicad_sch: TCMT4100 quad opto (PTT, UP, DOWN out;
    BUSY in, reversed), RF filters, R5/R6 ladder positions, D4, PTT LED,
    separate RGND radio ground
    - Root: template EEPROM parts renumbered (U6, R22, R23, C15, JP2) and
    header labels for GPIO17/27/22/23 made global so they reach the sheets
    - Generator: multi-unit symbols, global labels, deterministic UUIDs so
    rebuilds don't break schematic-to-PCB links; verifier checks RGND
    stays separate from GND and header pins reach each sheet
    [control.kicad_sch, pihat.kicad_sch, power.kicad_sch]
2026-11-02 Add KiCad radio connectors sheet
    - pihat/connectors.kicad_sch: J2/J3 RJ45 mic jacks wired pin for pin,
    J4/J5 patch headers (TK-880 example noted), J7 speaker, J8 busy,
    J9 accessory PTT, JP1 RGND-GND solder jumper (open)
    - Verifier covers the connector nets
    [connectors.kicad_sch, pihat.kicad_sch]
2026-11-02 Add KiCad codec and audio sheets, project library, RJHSE5380 jacks
    - pihat/codec.kicad_sch: TLV320AIC3104 with 33R series on MCLK/I2S,
    12 MHz oscillator (stock ASE symbol, 3225 pinout), reset pull-down,
    per-pin decoupling, unused pins marked no-connect
    - pihat/audio.kicad_sch: T1 TX path (-40 dB pad, C1, FB4, C7) and T2
    RX path (FB5/FB6, differential -26 dB pad, C2/C3)
    - Project library (pihat.kicad_sym, pihat.pretty) with TLV320AIC3104
    and SM-LP-5001 symbols and the SM-LP-5001 footprint, registered in
    sym-lib-table / fp-lib-table
    - Root: header I2S/I2C/reset labels renamed to HAT net names and made
    global; +3V3 PWR_FLAG clears the template's EEPROM supply error
    - RJ45 jacks now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
    [audio.kicad_sch, codec.kicad_sch, connectors.kicad_sch, jlc-bom.csv, pihat.kicad_sch]
2026-11-02 HAT ID EEPROM to the HAT design guide; J1 LCSC
    - U6 is now AT24C32D-SSHM-T (SOIC-8, C60583); A0-A2 tied to GND
    (datasheet: internal pull-downs only reliable below 3 pF coupling)
    - WP: R24 1k pull-up = write-protected by default; JP2 now to GND to
    enable writes; TP1 on WP; template note corrected
    - LCSC/footprints for R22, R23, C15, JP2; J1 2x20 socket = C2977589
    - Refresh the template's embedded R_Small symbol (KiCad 10, same pins)
    - Verifier covers the EEPROM nets; KiCad BoM export matches jlc-bom.csv
    [pihat.kicad_sch]
2026-11-02 Calculate TPS54360 compensation: R29 10k, C28 6.8nF, C29 47pF
    From the datasheet procedure (8.2.2.11) with 42 uF derated Cout,
    3 A, 5.06 V, ~643 kHz: fp 2.25 kHz, fco 26.9 kHz. All three are JLC
    Basic parts (C25804, C1631, C1671). Working shown on the power sheet;
    BoM CSV, BOM.md and the reference page updated.
    [jlc-bom.csv, power.kicad_sch]
2026-11-02 Add share-alike licences; drop unused submodule entry
    - Software: GPL-3.0-or-later (LICENSE)
    - Hardware (KiCad project, pihat/docs): CERN-OHL-S-2.0 (pihat/LICENSE)
    - Documentation: CC BY-SA 4.0 (docs/LICENSE)
    - README licence section; HAT README notes the source-location
    silkscreen text CERN-OHL-S asks for
    - Remove .gitmodules: the RPi_Hat_Template submodule was never used
    (the root sheet comes from KiCad's built-in Raspberry Pi HAT template)
2026-11-02 Move shared KiCad generator code to kicadgen/
    sexp, kicadlib, schbuild and the root-sheet HAT helpers (hatroot) now
    live at repo level so a second board can use them. Project symbol
    libraries are registered per board; project name and designators are
    passed in. pihat rebuilds byte-identical to the previous commit.
2026-11-02 Add SA818S HAT: Pi 4 HAT with a built-in 1 W UHF transceiver
    - sa818s-hat/: KiCad project from KiCad's built-in Raspberry Pi HAT
    template, project library (SA818S symbol + footprint cross-checked
    against two independent footprints and the datasheet drawing)
    - Sheets: Pi power (2 A fuse), separate 4.2 V module supply (second
    TPS54360, compensation calculated, 2 A ferrite), transceiver (SA818S,
    7th-order 500 MHz Chebyshev low-pass, Samtec edge SMA, MOSFET PTT
    that boots in receive, open-drain H/L, PD held low, 4.2->3.3 V level
    dividers, AudioON as busy), codec (shared), direct audio coupling
    - Generated with the shared kicadgen tools; netcheck.py added there.
    pihat's power/codec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
    [audio.kicad_sch, codec.kicad_sch, power.kicad_sch, rfpower.kicad_sch, sa818s-hat.kicad_pcb, sa818s-hat.kicad_sch, transceiver.kicad_sch]
2026-11-02 pihat: import schematic into PCB (layout in progress)
    All 96 footprints placed from the schematic; schematic parity check
    passes with 0 issues. Not yet routed.
    [pihat.kicad_pcb]
2026-11-02 sa818s-hat: wire the Pi interface circuits straight to the module pins
    RXD, TXD, PTT, H/L and AudioON were joined by local net labels and looked
    unconnected on the sheet. Each now has a drawn wire to its SA818S pin.
    Netlist unchanged (verify: all nets match), ERC clean.
    [transceiver.kicad_sch]
2026-11-02 Add SA818S radio driver; choose buttons or sa818 with radio.type
    - radio.type: buttons (default) keeps the existing external-radio mode for
    the Radio Remote HAT: PTT and channel UP/DOWN on the mic lines, sync
    - radio.type: sa818 drives the SA818S HAT over /dev/serial0:
    channel.list with frequency, repeater tx_freq, CTCSS/DCS, bandwidth,
    squelch and low power per channel; a VFO for any frequency in the band;
    RSSI polled while receiving; PD and H/L GPIOs; volume, filters and tail
    tone set at start-up; errors shown to operators and PTT refused while
    the module isn't answering, retried every 5 s
    - Shared PTT, busy, channel and state handling moved into a Radio base
    class; mock modu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
    [config.example.yaml, config.py, main.py, radio.py, sa818.py]
2026-11-03 Move audio to WebRTC for lower, steadier latency
    - Audio between browser and Pi now goes over WebRTC (Opus over UDP); the
    WebSocket keeps login, PTT, channels and meters, and still carries
    audio for browsers where WebRTC isn't available or doesn't connect
    - Signalling over the existing WebSocket (rtc_offer / rtc_answer,
    non-trickle). No STUN/TURN needed on a LAN or tailnet
    - Latency: aiortc's audio jitter buffer (fixed 80 ms, stalls up to
    320 ms on loss) replaced with a 4-packet one; RX queue capped at 60 ms;
    browser asked for a minimal receive buffer; smaller radio-side TX
    buffer for WebRTC operators
    - PTT release waits release_ms for packets in flight, then stops taking
    the s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
    [audio.py, config.example.yaml, config.py, main.py, rtc.py]
2026-11-03 Show the control head in the web app
    The control head replaces the HTML LCD and the channel up/down buttons:
    - Its screen shows the channel, name, frequency (or error / who is
    transmitting), TX with the timeout countdown, CHG, BUSY, RSSI in dBm,
    LOW power and signal bars.
    - The channel knob and D-pad up/down pick a channel on the screen straight
    away, and one goto is sent once the knob stops for 400 ms. Picks are
    refused while anyone transmits, and an unsent pick is dropped on PTT.
    - The volume knob and the Speaker volume slider drive the same playback
    gain and follow each other.
    - Holding power for 1.5 s disconnects. Holding emergency only shows a
    notice and is not wired to anyt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
2026-11-03 Add a portrait handheld template for phones
    build_handheld.py draws a handheld radio in the same style as the desk
    head and writes web/control-head/handheld.svg plus PNGs, a layout file and
    a test page to assets/control-head/output/. It uses the same screen ids and
    control names, with three soft keys, home/menu/P1/P2 and a D-pad on
    rocker rows. Its top knobs are seen side-on.
    control_head.js:
    - createRadioHead(svg) wires any template, so the app can swap them. Pages
    that already contain an SVG still get a ready-made radioHead.
    - Side-on knobs (data-view="side") roll with a swipe, and their ridges
    slide instead of rotating. The volume sweep comes from data-sweep.
    App: phones (600 px and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
2026-11-05 Add selcall: send and decode sequential tone calls
    server/selcall.py encodes 1-20 digit calls in CCIR, ZVEI-1 or EEA, with
    the repeat tone for repeated digits. Its decoder finds each frame's peak
    frequency and matches it to the nearest tone. It accepts tones up to
    about 2% off, ignores sequences shorter than decode_min_digits, and
    skips the tail of a call that was in progress when we unkeyed.
    The server:
    - {"type":"selcall","digits":...} keys the radio, waits tx_delay_ms,
    plays the tones through the normal TX audio path, then unkeys.
    - PTT is refused while a call goes out, and a call can't start while
    anyone transmits.
    - Received audio is decoded whenever the radio isn't transmitting.
    -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
    [audio.py, config.example.yaml, config.py, main.py, selcall.py]
2026-11-05 Selcall in the web app: P / P1 sends, calls show on the head
    - Selcall panel: the number to call (digits only), presets, and a list
    of recent calls sent and heard. Tapping a list entry fills the number.
    - P on the desk head or P1 on the handheld sends the number. Desk soft
    key 3 (Call) jumps to the panel.
    - The head shows "Sending selcall …" while transmitting, and calls heard
    on its bottom line for 10 s. A call to this radio also gets a notice
    and a short chime.
    - The PTT button reads SELCALL while a call goes out.
    - README: a Selcall section, the new controls and protocol messages.
2026-11-05 Selcall: configurable tone length (selcall.tone_ms)
    Runs the chosen standard's frequencies at another tone length, such as
    CCIR at 50 ms, from 30 to 200 ms. null keeps the standard's own (ccir 100,
    zvei1 70, eea 40). The decoder's timing follows it. A decoder set for
    short tones still hears calls with longer ones. The Selcall panel shows
    the tone length in use.
    [audio.py, config.example.yaml, config.py, main.py, selcall.py]
2026-11-05 Send selcalls with the Call soft key; P and P1 unassigned again
    Call sends the number in the Selcall panel. With none entered, it opens
    the panel and puts the cursor in the number field. The desk head keeps
    Call on soft key 3. On the handheld, Call replaces Chans on soft key 1
    (Chans comes back if selcall is off).
    Soft key actions now run just after the press. The pressed key was
    taking focus back from fields that Tune and Call focus.
    [config.example.yaml]
2026-11-08 Audio clips on the server: store uploads, play them on air
    server/clips.py keeps uploaded clips as mono 16-bit WAV at the wire rate with a clips.json
    list, checks uploads and evens out their level when played. POST /clips takes uploads,
    authorised by a per-login token; clip_play / clip_stop / clip_delete arrive over the
    WebSocket, and every operator gets the list when it changes.
    Selcalls and clips share one transmit routine (_transmit): key, keyed lead-in, play,
    unkey. PTT is refused while either is on air, and any operator can stop a clip.
    New config section clips: (enabled, dir, max_seconds, max_files, tx_delay_ms, level).
2026-11-08 Audio clips panel and the head's Play key
    Upload audio in the new Audio clips panel: the browser decodes each file (MP3 or anything
    it can play), mixes it to mono at the wire rate, trims silent ends and uploads a WAV.
    Pick a clip and press Play on the head to transmit it; the key shows Stop while a clip is
    on air. Desk soft key 4 is Play; on the handheld, Play takes the middle key (Tune/Sync
    there when clips are off).
2026-11-08 Control head: orange button is a plain press; add it to the handheld
    The orange (emergency) button no longer needs the 1.5 s hold: the remote uses it as Record,
    which never transmits. Power keeps its hold. The handheld gets an orange top button beside
    the antenna, as on real handhelds, with the same control name, so both heads report
    {control: "emergency", action: "press"}.
2026-11-08 Record received audio into the clip list
    server/recorder.py writes received audio to WAV parts of record.max_minutes (15) in the clips
    folder; each finished part is listed as a recording (kind "rec"), and the next starts with
    no gap. Recording survives a restart, a part cut off by a power failure is recovered on the
    next start, the oldest recordings go once they pass record.keep_mb, and recording stops if
    the disk gets down to record.min_free_mb.
    Also: GET /clips/<id>.wav to listen to or save any clip, max_files counts uploads only, and
    clips too long for ptt.max_tx_seconds are refused for transmit.
    [clips.py, config.example.yaml, config.py, main.py, recorder.py]
2026-11-08 Recording in the web app: orange button, REC on the head, record bar
    The orange button toggles recording; while recording, any other control except the volume
    knob stops it and does nothing else. The head shows REC, the clips panel shows a record bar
    with the running time and a Record/Stop button, and every clip gets a Listen link.
    Recordings too long to transmit can't be picked for Play.
2026-11-08 TX tone control: bass and treble shelves for voice and clips
    Phone and laptop mics sound thin on FM. Transmitted voice (WebSocket and WebRTC) and clips
    now pass through a bass shelf (+6 dB below 400 Hz) and treble shelf (-3 dB above 2.5 kHz),
    set with audio.tx_bass_db/_hz and audio.tx_treble_db/_hz. The shelves are built as a
    255-tap linear-phase FIR (8 ms delay), cheap enough per 20 ms frame on a Pi. Clips are
    levelled after the EQ, so they keep their peak level. Selcall tones bypass it.
2026-11-08 Voice effects: Vader, Dalek, Demon, Robot, Giant, Female, Chipmunk, Ghost
    server/voicefx.py builds each preset from small streaming effects that take audio blocks of
    any length: a delay-line pitch shifter, ring modulator, combs, a rough reverb, STFT
    robotisation and whispering, saturation and the eq.py shelves. Each preset is level-matched
    to a speech-like test signal at start-up and soft-limited.
    Each operator picks a preset in the new Voice effects panel; P (desk) or P1 (handheld)
    switches it on and off, and the head shows FX. The Pi applies it to the transmitting
    operator's live voice only, before the tone control; clips and selcalls are untouched.
    New config: voice_fx.enabled.
2026-11-08 Voice effects: resynthesise the voice instead of pitch-shifting it
    The pitch-shifted presets still let the speaker's own voice through. Every preset now starts
    with Resynth, a source-filter resynthesis: each 8 ms it takes the spectral envelope of the
    last 32 ms (cepstral smoothing), stretches it for a different vocal tract size, and plays it
    through a new synthetic source (band-limited pulses at the preset's pitch, following only
    part of the speaker's intonation, plus noise for unvoiced sounds and breath). The speaker's
    pitch, roughness and timbre never reach the output; only timing and articulation do.
    Presets now set warp (tract size), f0, keep (intonation), sub (octave-down growl) and bre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
    [voicefx.py]
2026-11-08 pihat: simplify the passives (72 to 52 fitted)
    - Power: LMR33640ADDA synchronous buck with internal compensation replaces the TPS54360,
    dropping catch diode D2, compensation R29/C28/C29 and frequency resistor R28. Feedback is
    82k/20k (5.10 V); C28 is now the VCC bypass. D3 becomes an SMBJ22A, clamping under the
    LMR33640's 38 V maximum. U5 shares C25 instead of its own C26.
    - Codec: no 33R on the I2S lines (R17-R20); R16 stays on MCLK.
    - Control: no ferrite/100 pF on UP and DOWN (FB2/FB3, C5/C6); PTT keeps FB1/C4. R5/R6 are
    not fitted, bridged by closed solder jumpers JP3/JP4 (fit them for ladder radios).
    - Audio: no TX pad (R9/R10), the codec sets the level; no RX ferrites (FB5/FB6),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
    [audio.kicad_sch, codec.kicad_sch, control.kicad_sch, power.kicad_sch]
2026-11-08 pihat: update schematic page and BOM for the simplified board
    Redrawn power, control, codec and audio sheets, netlist, header table, parts list (18
    Basic, 17 Extended) and pre-layout checks: U3 stock, U5 next to U4. jlc-bom.csv matches the
    KiCad BOM designator for designator.
    [jlc-bom.csv]
2026-11-09 pihat: XY2500R-G 3.5 mm pluggable headers for all radio connections
    Replace the RJ45 mic jacks (J2/J3), patch headers (J4/J5) and screw terminals (J6-J9) with
    three Xinlaiya XY2500R-G-3.5 right-angle, closed-end pluggable headers (8 A / 300 V):
    J2 13.8 V in, 2 way (C880572)
    J3 audio, 4 way (C880574): TX, TX return, RX+, RX-
    J4 radio, 6 way (C880576): RGND, PTT, UP, DOWN, BUSY+, BUSY-
    Footprints are KiCad's Phoenix MC 1,5/x-G-3,5, which these copy. sheet_power takes the
    input connector as an option; the SA818S HAT still regenerates unchanged. ERC: 0 errors;
    verify.py: all nets match; jlc-bom.csv matches the KiCad BOM. Schematic page and BOM notes
    updated.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
    [connectors.kicad_sch, control.kicad_sch, jlc-bom.csv, power.kicad_sch]
2026-11-09 3D models for every footprint on both boards
    New kicad-shared/ (kicadgen/sharedlib.py, called by both builds):
    - 3dmodels/: exact-part STEP models from LCSC/EasyEDA for the SM-LP-5001E transformer,
    SA818S module, 1812 PTC and 3225 oscillator, each checked to sit centred at z = 0.
    - radio-remote.pretty/: copies of stock footprints whose model is missing or renamed in
    KiCad 10 (Fuse_1812, Oscillator ASE 3225, TI HSOP-8 / SO-PowerPAD-8), with fixed models.
    Both projects reach it via ${KIPRJMOD}/../kicad-shared.
    The transformer and SA818S footprint generators now carry their models. The FXL0630
    inductors (L1; L2 on the SA818S board) use KiCad's exact L_Changjiang_FXL0630 footprint
    and model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
    [Bourns_SM-LP-5001E.step, NiceRF_SA818S.step, Oscillator_3225_HSO321S.step, PTC_1812_4.5x3.2x1.0mm.step, codec.kicad_sch, jlc-bom.csv, pihat.kicad_pcb, power.kicad_sch]
2026-11-09 pihat PCB: one reference per part, on the silkscreen, centred
    Includes the board after Update PCB from Schematic (simplified parts, J2-J4 headers).
    Each footprint's silkscreen reference now sits where its fab-layer reference was (in the
    middle of the part) at the fab size, min 0.5 mm / 0.1 mm stroke, and the fab copy is
    deleted. T1/T2, which had no fab reference, are centred on the body. Board min text height
    is now 0.5 mm to match. tools/kicad/centre_refs.py does this and is safe to re-run after
    later schematic updates.
    [pihat.kicad_pcb]
2026-11-09 pihat: routed board; add C26 back at U5's input
    Routed PCB from KiCad (closed outline, designators matching the schematic, solid SW pour
    connection, no opens or clearance errors). U5 ended up away from U4, so it gets its own
    1 uF input capacitor again (C26, C15849, Basic): sheet_power's default u5_cin=True.
    ERC 0 errors, all nets match; C26 still needs placing on the PCB (Update PCB from
    Schematic).
    [jlc-bom.csv, pihat.kicad_pcb, power.kicad_sch]
2026-11-09 pihat: vertical XY2500V-F 3.5 mm headers, plugged in from above
    J2/J3/J4 become Xinlaiya XY2500V-F-3.5-2P/4P/6P (C880554/C880556/C880558): vertical,
    closed ends, 8 A / 300 V, so the plugs go in through the HAT opening.
    kicadgen/sharedlib.py now generates their footprints from LCSC's data for the exact parts
    (1.4 mm drills, 2.2 mm pads, body 4 mm behind / 3 mm in front of the pins) with LCSC's STEP
    models. The origin is pin 1, as on the Phoenix MC footprints they replace, so Update PCB
    from Schematic keeps every pad in place and the routing connected (checked on a copy of
    the board: no courtyard, clearance or connection problems). LCSC's STEP sits 10.5 mm low
    and 7.1 mm off front-to-back; th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
    [Xinlaiya_XY2500V-F-3.5-2P.step, Xinlaiya_XY2500V-F-3.5-4P.step, Xinlaiya_XY2500V-F-3.5-6P.step, connectors.kicad_sch, jlc-bom.csv, power.kicad_sch]
2026-11-09 pihat: finished layout
    Vertical XY2500V-F headers placed (F8), C26 at U5's input, tidy-up, and six dangling
    track stubs removed; zones refilled. DRC: 0 unconnected, 0 clearance, 0 schematic parity
    issues. Left as warnings: silk clipped at pads (centred references), thin thermal spokes on
    small GND pads, F1/J2 courtyard corners (0.2 mm, margins only), the copyright text's stroke
    weight, and the stock TI thermal-via footprint's type.
    [pihat.kicad_pcb]
2026-11-09 pihat: J1-J4 Do Not Populate (hand-soldered); correct the codec clocking notes
    J1 (Pi header) and J2-J4 (pluggable headers) are DNP and out of the BOM in the generated
    schematic, matching the PCB, so Update PCB from Schematic keeps them that way; R5/R6 are
    out of the BOM too. JLC assembles SMD only (Economic), 13 Extended parts; jlc-bom.csv has
    62 placements. ERC 0 errors, all nets match, 0 parity issues.
    The stock dacberry400 overlay clocks the codec PLL from BCLK while claiming 12 MHz, which
    is wrong for this board (Y1 drives MCLK). README and the schematic's checks now say to use
    a small simple-audio-card overlay instead, and warn against powering the Pi from USB-C with
    the HAT fitted bu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
    [connectors.kicad_sch, control.kicad_sch, jlc-bom.csv, pihat.kicad_pcb, pihat.kicad_sch, power.kicad_sch]
2026-11-09 pihat: project setting from KiCad (solder mask to copper clearance 0.005 mm)
2026-11-09 sa818s-hat: PCB work in progress from KiCad
    Footprints imported into the board and project settings saved by KiCad. Not yet checked.
    [sa818s-hat.kicad_pcb]
2026-11-09 Accounts, roles, sessions and an audit log; tighter security
    server/auth.py keeps operator accounts in SQLite (radio.db, mode 600): scrypt password
    hashes, 'keep me logged in' sessions stored only as SHA-256 hashes with sliding expiry, and
    an audit log. Roles: control (everything) and listen (hear only); the server refuses control
    messages and clip uploads from listen accounts. server/users.py is the radio-users tool
    (add, passwd, role, name, disable/enable, delete, sessions, logout, log).
    Logins take a username and password or a session token. Five failures lock the address and
    the username for 15 min; unknown usernames cost the same scrypt as wrong passwords, run off
    the event loop. Conne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
    [auth.py, config.example.yaml, config.py, main.py, users.py]
2026-11-09 Recording: VOX mode and both sides of the conversation
    VOX ('only while the channel is active'): records the overs back to back with a short gap,
    from the busy line (or RX level), or while we transmit. Each over keeps 0.5 s of pre-roll and
    runs on 2 s after it; a part is finished after 10 min of quiet so it shows in the list. The
    page has a tick box for it (also used by the orange button; record.mode sets the default),
    and the record bar shows how much has been captured.
    Our own transmissions: both audio backends keep a copy of what goes to the radio (after
    voice effects; selcalls and clips too), at the wire rate and without tx_gain, taken one frame
    per RX frame so it stays in step. While k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
    [audio.py, config.example.yaml, config.py, main.py, recorder.py]
2026-11-10 Rename clips and recordings
    A Rename button beside each clip (control accounts) asks for a new name, up to 40
    characters, and the change shows for every operator. Works for uploads and recording parts;
    renaming the clip on air updates its name on the display. Blank names are refused, and each
    rename is in the audit log with the old and new name.
2026-11-11 SA818S HAT: power from the Pi only, low-noise supply, RF/noise parts review
    Power: no 13.8 V input any more. The board runs from the Pi's 5 V (Pi powered from its
    USB-C socket). Removed the input connector, fuse, TVS/reverse diodes, 100 uF electrolytic and
    both TPS54360 bucks.
    Module supply: TPS7A9401DSCR ultra-low-noise LDO (0.46 uVrms, PSRR 110 dB at 1 kHz / 50 dB at
    1 MHz) at 4.2 V, laid out as TI's typical application: 10 uF in, 10 uF + 1 uF out, 10 uF on
    NR/SS, SNS at the output caps, UVLO at 3.9 V, full 1.3 A current limit. R31 (28.0k 0.1% thin
    film) sets the voltage. Then FB1 with a 10 uF X7R and a 100 uF polymer tantalum (damps the
    pi-filter, holds up the TX key-up step). R34: unfit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
    [TI_WSON-10_DSC.step, audio.kicad_sch, codec.kicad_sch, power.kicad_sch, rfpower.kicad_sch, sa818s-hat.kicad_pcb, transceiver.kicad_sch]
2026-11-11 SA818S HAT: run the codec's 1.8 V regulator from 5 V, not the analog 3.3 V rail
    U5 (TPS7A2018, codec DVDD) was fed from U4's +3.3VA output, so the digital core's
    clock-rate current pulses were drawn from the same node as the codec's AVDD/DRVDD. U5 now
    has its own input from +5V (C26), and +3.3VA feeds only the analog supplies. C24/C26/C27 X7R.
    The pihat board is unchanged (its generated sheets are identical).
    [power.kicad_sch]
2026-11-11 SA818S HAT: drop the EEPROM write-enable jumper JP1
    WP stays pulled up by R3 (write-protected); ground TP1 while writing the EEPROM. Removed
    JP1, its ground symbol and the stub from the root sheet (hatroot.drop_wp_jumper) and its
    footprint from the board.
    [sa818s-hat.kicad_pcb, sa818s-hat.kicad_sch]
2026-11-11 SA818S HAT: vertical SMD SMA, references centred on the silkscreen
    J3 is now a Kinghelm KH-SMAK-SMT (LCSC C22371060): vertical SMA, surface mount, 50 ohm DC-6 GHz.
    It can sit right at the filter output, and the antenna screws on through the top of the case.
    Footprint generated in the shared library (pads as LCSC's footprint); LCSC's STEP is drawn
    thread-down, so the footprint turns it 180 degrees about X (checked in renders).
    Silkscreen: centre_refs.py now takes a board path; run on this board, every reference moved
    from the fab layer to the silkscreen at the part's centre (75 parts). min_text_height 0.5 mm
    as on the pihat. Re-run it after Update PCB from Schematic adds or replaces parts.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
    [Kinghelm_KH-SMAK-SMT.step, sa818s-hat.kicad_pcb, transceiver.kicad_sch]
2026-11-11 SA818S HAT board: updated from the schematic, new parts' references centred
    [sa818s-hat.kicad_pcb]
2026-11-11 SA818S HAT: GPIO socket J1 Do Not Populate (hand-soldered; out of the BOM and placement file)
    [sa818s-hat.kicad_pcb, sa818s-hat.kicad_sch]
2026-11-11 SA818S HAT: R31 (sets the module's 4.2 V) gets a JLC part: FH TD03G2802BT, C667083
    28.0k 0.1% 25 ppm/C thin film 0603, as specified. Alternative: Vishay TNPW060328K0BHEA (C1714791).
    Every fitted part now has an LCSC code.
    [rfpower.kicad_sch, sa818s-hat.kicad_pcb]
2026-11-11 SA818S HAT layout: 50 ohm RF line, filter rework, J1 thermal reliefs
    Layout progress: RF path 1.2 mm with a 0.2 mm gap to the pour (about 50 ohm grounded CPW),
    closer filter ground vias, L4 turned 90 degrees, clearance and connection fixes.
    J1 (hand-soldered) uses thermal reliefs; pins 9, 25 and 30 stay solid because routing leaves
    no room for spokes there.
    [sa818s-hat.kicad_pcb]
2026-11-12 SA818S HAT: through-hole vertical SMA (J3, hand-soldered, DNP); layout progress
    J3 back to a through-hole vertical SMA (KiCad's Amphenol 132134-11 footprint: 1.7 mm holes on a
    5.08 mm square, fits most vertical THT SMA jacks), Do Not Populate, out of the BOM and placement
    file. Swapped in place on the board, keeping position and nets.
    Layout: module turned horizontal with the filter along the bottom edge to J3, transmit pad
    next to the module's MIC pin, C45 within about 2 mm of VBAT, dangling filter stub removed.
    [sa818s-hat.kicad_pcb, transceiver.kicad_sch]
2026-11-12 SA818S HAT layout: silkscreen tidied, title text fixed
    [sa818s-hat.kicad_pcb]
2026-11-12 SA818S HAT: R48 (Pi TX -> module RXD) 1k -> 10k
    The SA818S datasheet says RXD must be pulled low before the module sleeps, to avoid current
    leakage and a poor reset on the next wake. The module sleeps (R43) from power-up until the server
    starts, while the Pi's TX idles high: 10k keeps that leakage under 0.3 mA. Same footprint;
    10k (C25804) is already on the BOM.
    [sa818s-hat.kicad_pcb, transceiver.kicad_sch]
2026-11-12 SA818S HAT layout: clean-up, logo and silkscreen
    [sa818s-hat.kicad_pcb]
2026-11-12 Rename the project to RadPi; one-page SA818 HAT schematic
    Rename Radio Remote to RadPi: the boards are now the RadPi Control HAT
    (pihat/) and the RadPi SA818 HAT (sa818s-hat/). Install path /opt/radpi,
    service radpi, accounts tool radpi-users, KiCad library radpi.pretty.
    update.sh moves an old /opt/radio-remote install over once (config,
    accounts, clips, certificates), swaps the service and tool, and rebuilds
    the venv.
    Add sa818s-hat/docs/schematic.svg: every sheet cropped and tiled on one
    page (kicadgen/overview.py, tools/overview.py), shown in the README.
    Codec sheet: move PWR_FLAG off the +3V3 symbol, and shorten C13's value
    so it no longer overlaps C11.
    [audio.kicad_sch, codec.kicad_sch, connectors.kicad_sch, control.kicad_sch, pihat.kicad_pcb, power.kicad_sch, rfpower.kicad_sch, sa818s-hat.kicad_pcb]
2026-11-12 Control HAT: one-page schematic in the README
    Add pihat/docs/schematic.svg (tools/kicad/overview.py): all sheets cropped
    and tiled on one page. Fix two text overlaps it showed: the TX level note
    on the audio sheet ran into HP_P, and U3's value sat on its GND symbol.
    [audio.kicad_sch, power.kicad_sch]
2026-11-12 SA818 HAT v1.1: harmonic filter re-tuned for 477 MHz
    7th-order low-pass now 5.6 pF / 18 nH / 13 pF / 18 nH / 13 pF / 18 nH /
    5.6 pF (-3 dB at about 550 MHz): simulated 0.62 dB loss at 477 MHz (was
    1.1 dB), return loss better than 22 dB across 400-480 MHz, about -57 dB at
    the 2nd harmonic of 477.
    Parts: Murata LQW18AN18NG80D (lowest-DCR 0603 18 nH at LCSC) and Murata
    GJM high-Q C0G capacitors, all 0402 (C42/C43 were 0603). Board marked
    v1.1, ground vias tidied. README: the module covers 400-480 MHz.
    [sa818s-hat.kicad_pcb, transceiver.kicad_sch]
2026-11-14 Google TTS: Chirp 3 HD voices (no pitch/gain for them); example uses en-AU-Chirp3-HD-Fenrir
