nm4c/radio-remote/(notices)

Notices in the files:
sa818s-hat/sa818s-hat.kicad_pcb:
RadPi SA818 Hat v1.1 © NMc 2026
